zeruns/Synchronous-Rectification-Buck-Boost-Digital-Power-Supply-Based-on-STM32/MDK-ARM/build/Buck-Boost/Buck-Boost.htm

# Static Call Graph for image ./build/Buck-Boost/Buck-Boost.axf

#<CALLGRAPH># ARM Linker, 6210000: Last Updated: Tue Jun 4 23:03:58 2024

### Maximum Stack Usage = 508 bytes + Unknown(Functions without stacksize, Cycles, Untraceable Function Pointers)

### Call chain for Maximum Stack Depth:

__rt_entry_main ⇒ main ⇒ MX_HRTIM1_Init ⇒ HAL_HRTIM_WaveformTimerConfig

### Functions with no stack information

- __user_initial_stackheap

### Mutually Recursive functions

- ADC1_2_IRQHandler ⇒ ADC1_2_IRQHandler
- BusFault_Handler ⇒ BusFault_Handler
- HardFault_Handler ⇒ HardFault_Handler
- MemManage_Handler ⇒ MemManage_Handler
- UsageFault_Handler ⇒ UsageFault_Handler

### Function Pointers

- ADC1_2_IRQHandler from startup_stm32g474xx.o(.text) referenced from startup_stm32g474xx.o(RESET)
- ADC3_IRQHandler from startup_stm32g474xx.o(.text) referenced from startup_stm32g474xx.o(RESET)
- ADC4_IRQHandler from startup_stm32g474xx.o(.text) referenced from startup_stm32g474xx.o(RESET)
- ADC5_IRQHandler from startup_stm32g474xx.o(.text) referenced from startup_stm32g474xx.o(RESET)
- ADC_DMAConvCplt from stm32g4xx_hal_adc.o(.text.ADC_DMAConvCplt) referenced 2 times from stm32g4xx_hal_adc.o(.text.HAL_ADC_Start_DMA)
- ADC_DMAError from stm32g4xx_hal_adc.o(.text.ADC_DMAError) referenced 2 times from stm32g4xx_hal_adc.o(.text.HAL_ADC_Start_DMA)
- ADC_DMAHalfConvCplt from stm32g4xx_hal_adc.o(.text.ADC_DMAHalfConvCplt) referenced 2 times from stm32g4xx_hal_adc.o(.text.HAL_ADC_Start_DMA)
- BusFault_Handler from stm32g4xx_it.o(.text.BusFault_Handler) referenced from startup_stm32g474xx.o(RESET)
- COMP1_2_3_IRQHandler from startup_stm32g474xx.o(.text) referenced from startup_stm32g474xx.o(RESET)
- COMP4_5_6_IRQHandler from startup_stm32g474xx.o(.text) referenced from startup_stm32g474xx.o(RESET)
- COMP7_IRQHandler from startup_stm32g474xx.o(.text) referenced from startup_stm32g474xx.o(RESET)
- CORDIC_IRQHandler from startup_stm32g474xx.o(.text) referenced from startup_stm32g474xx.o(RESET)
- CRS_IRQHandler from startup_stm32g474xx.o(.text) referenced from startup_stm32g474xx.o(RESET)
- DMA1_Channel1_IRQHandler from stm32g4xx_it.o(.text.DMA1_Channel1_IRQHandler) referenced from startup_stm32g474xx.o(RESET)
- DMA1_Channel2_IRQHandler from stm32g4xx_it.o(.text.DMA1_Channel2_IRQHandler) referenced from startup_stm32g474xx.o(RESET)
- DMA1_Channel3_IRQHandler from stm32g4xx_it.o(.text.DMA1_Channel3_IRQHandler) referenced from startup_stm32g474xx.o(RESET)
- DMA1_Channel4_IRQHandler from startup_stm32g474xx.o(.text) referenced from startup_stm32g474xx.o(RESET)
- DMA1_Channel5_IRQHandler from startup_stm32g474xx.o(.text) referenced from startup_stm32g474xx.o(RESET)
- DMA1_Channel6_IRQHandler from startup_stm32g474xx.o(.text) referenced from startup_stm32g474xx.o(RESET)
- DMA1_Channel7_IRQHandler from startup_stm32g474xx.o(.text) referenced from startup_stm32g474xx.o(RESET)
- DMA1_Channel8_IRQHandler from startup_stm32g474xx.o(.text) referenced from startup_stm32g474xx.o(RESET)
- DMA2_Channel1_IRQHandler from startup_stm32g474xx.o(.text) referenced from startup_stm32g474xx.o(RESET)
- DMA2_Channel2_IRQHandler from startup_stm32g474xx.o(.text) referenced from startup_stm32g474xx.o(RESET)
- DMA2_Channel3_IRQHandler from startup_stm32g474xx.o(.text) referenced from startup_stm32g474xx.o(RESET)
- DMA2_Channel4_IRQHandler from startup_stm32g474xx.o(.text) referenced from startup_stm32g474xx.o(RESET)
- DMA2_Channel5_IRQHandler from startup_stm32g474xx.o(.text) referenced from startup_stm32g474xx.o(RESET)
- DMA2_Channel6_IRQHandler from startup_stm32g474xx.o(.text) referenced from startup_stm32g474xx.o(RESET)
- DMA2_Channel7_IRQHandler from startup_stm32g474xx.o(.text) referenced from startup_stm32g474xx.o(RESET)
- DMA2_Channel8_IRQHandler from startup_stm32g474xx.o(.text) referenced from startup_stm32g474xx.o(RESET)
- DMAMUX_OVR_IRQHandler from startup_stm32g474xx.o(.text) referenced from startup_stm32g474xx.o(RESET)
- DebugMon_Handler from stm32g4xx_it.o(.text.DebugMon_Handler) referenced from startup_stm32g474xx.o(RESET)
- EXTI0_IRQHandler from stm32g4xx_it.o(.text.EXTI0_IRQHandler) referenced from startup_stm32g474xx.o(RESET)
- EXTI15_10_IRQHandler from startup_stm32g474xx.o(.text) referenced from startup_stm32g474xx.o(RESET)
- EXTI1_IRQHandler from startup_stm32g474xx.o(.text) referenced from startup_stm32g474xx.o(RESET)
- EXTI2_IRQHandler from startup_stm32g474xx.o(.text) referenced from startup_stm32g474xx.o(RESET)
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
- RTC_WKUP_IRQHandler from startup_stm32g474xx.o(.text) referenced from startup_stm32g474xx.o(RESET)
- Reset_Handler from startup_stm32g474xx.o(.text) referenced from startup_stm32g474xx.o(RESET)
- SAI1_IRQHandler from startup_stm32g474xx.o(.text) referenced from startup_stm32g474xx.o(RESET)
- SPI1_IRQHandler from startup_stm32g474xx.o(.text) referenced from startup_stm32g474xx.o(RESET)
- SPI2_IRQHandler from startup_stm32g474xx.o(.text) referenced from startup_stm32g474xx.o(RESET)
- SPI3_IRQHandler from startup_stm32g474xx.o(.text) referenced from startup_stm32g474xx.o(RESET)
- SPI4_IRQHandler from startup_stm32g474xx.o(.text) referenced from startup_stm32g474xx.o(RESET)
- SVC_Handler from stm32g4xx_it.o(.text.SVC_Handler) referenced from startup_stm32g474xx.o(RESET)
- SysTick_Handler from stm32g4xx_it.o(.text.SysTick_Handler) referenced from startup_stm32g474xx.o(RESET)
- SystemInit from system_stm32g4xx.o(.text.SystemInit) referenced from startup_stm32g474xx.o(.text)
- TIM1_BRK_TIM15_IRQHandler from startup_stm32g474xx.o(.text) referenced from startup_stm32g474xx.o(RESET)
- TIM1_CC_IRQHandler from startup_stm32g474xx.o(.text) referenced from startup_stm32g474xx.o(RESET)
- TIM1_TRG_COM_TIM17_IRQHandler from startup_stm32g474xx.o(.text) referenced from startup_stm32g474xx.o(RESET)
- TIM1_UP_TIM16_IRQHandler from startup_stm32g474xx.o(.text) referenced from startup_stm32g474xx.o(RESET)
- TIM20_BRK_IRQHandler from startup_stm32g474xx.o(.text) referenced from startup_stm32g474xx.o(RESET)
- TIM20_CC_IRQHandler from startup_stm32g474xx.o(.text) referenced from startup_stm32g474xx.o(RESET)
- TIM20_TRG_COM_IRQHandler from startup_stm32g474xx.o(.text) referenced from startup_stm32g474xx.o(RESET)
- TIM20_UP_IRQHandler from startup_stm32g474xx.o(.text) referenced from startup_stm32g474xx.o(RESET)
- TIM2_IRQHandler from stm32g4xx_it.o(.text.TIM2_IRQHandler) referenced from startup_stm32g474xx.o(RESET)
- TIM3_IRQHandler from stm32g4xx_it.o(.text.TIM3_IRQHandler) referenced from startup_stm32g474xx.o(RESET)
- TIM4_IRQHandler from stm32g4xx_it.o(.text.TIM4_IRQHandler) referenced from startup_stm32g474xx.o(RESET)
- TIM5_IRQHandler from startup_stm32g474xx.o(.text) referenced from startup_stm32g474xx.o(RESET)
- TIM6_DAC_IRQHandler from startup_stm32g474xx.o(.text) referenced from startup_stm32g474xx.o(RESET)
- TIM7_DAC_IRQHandler from startup_stm32g474xx.o(.text) referenced from startup_stm32g474xx.o(RESET)
- TIM8_BRK_IRQHandler from startup_stm32g474xx.o(.text) referenced from startup_stm32g474xx.o(RESET)
- TIM8_CC_IRQHandler from startup_stm32g474xx.o(.text) referenced from startup_stm32g474xx.o(RESET)
- TIM8_TRG_COM_IRQHandler from startup_stm32g474xx.o(.text) referenced from startup_stm32g474xx.o(RESET)
- TIM8_UP_IRQHandler from startup_stm32g474xx.o(.text) referenced from startup_stm32g474xx.o(RESET)
- UART4_IRQHandler from startup_stm32g474xx.o(.text) referenced from startup_stm32g474xx.o(RESET)
- UART5_IRQHandler from startup_stm32g474xx.o(.text) referenced from startup_stm32g474xx.o(RESET)
- UART_DMAAbortOnError from stm32g4xx_hal_uart.o(.text.UART_DMAAbortOnError) referenced 2 times from stm32g4xx_hal_uart.o(.text.HAL_UART_IRQHandler)
- UART_DMAError from stm32g4xx_hal_uart.o(.text.UART_DMAError) referenced 2 times from stm32g4xx_hal_uart.o(.text.HAL_UART_Transmit_DMA)
- UART_DMATransmitCplt from stm32g4xx_hal_uart.o(.text.UART_DMATransmitCplt) referenced 2 times from stm32g4xx_hal_uart.o(.text.HAL_UART_Transmit_DMA)
- UART_DMATxHalfCplt from stm32g4xx_hal_uart.o(.text.UART_DMATxHalfCplt) referenced 2 times from stm32g4xx_hal_uart.o(.text.HAL_UART_Transmit_DMA)
- UCPD1_IRQHandler from startup_stm32g474xx.o(.text) referenced from startup_stm32g474xx.o(RESET)
- USART1_IRQHandler from stm32g4xx_it.o(.text.USART1_IRQHandler) referenced from startup_stm32g474xx.o(RESET)
- USART2_IRQHandler from startup_stm32g474xx.o(.text) referenced from startup_stm32g474xx.o(RESET)
- USART3_IRQHandler from startup_stm32g474xx.o(.text) referenced from startup_stm32g474xx.o(RESET)
- USBWakeUp_IRQHandler from startup_stm32g474xx.o(.text) referenced from startup_stm32g474xx.o(RESET)
- USB_HP_IRQHandler from startup_stm32g474xx.o(.text) referenced from startup_stm32g474xx.o(RESET)
- USB_LP_IRQHandler from startup_stm32g474xx.o(.text) referenced from startup_stm32g474xx.o(RESET)
- UsageFault_Handler from stm32g4xx_it.o(.text.UsageFault_Handler) referenced from startup_stm32g474xx.o(RESET)
- WWDG_IRQHandler from startup_stm32g474xx.o(.text) referenced from startup_stm32g474xx.o(RESET)
- __main from __main.o(!!!main) referenced from startup_stm32g474xx.o(.text)
- _get_lc_ctype from lc_ctype_c.o(locale$$code) referenced from rt_ctype_table.o(.text)
- _printf_input_char from _printf_char_common.o(.text) referenced from _printf_char_common.o(.text)
- _snputc from _snputc.o(.text) referenced from vsnprintf.o(.text)
- _sputc from _sputc.o(.text) referenced from vsprintf.o(.text)

### Global Symbols

__main (Thumb, 8 bytes, Stack size 0 bytes, __main.o(!!!main))

[Calls]

- >> __rt_entry
- >> __scatterload

[Address Reference Count : 1]

- startup_stm32g474xx.o(.text)

__scatterload (Thumb, 0 bytes, Stack size unknown bytes, __scatter.o(!!!scatter))

[Called By]

- >> __main

__scatterload_rt2 (Thumb, 84 bytes, Stack size unknown bytes, __scatter.o(!!!scatter), UNUSED)

[Calls]

- >> __rt_entry

__scatterload_rt2_thumb_only (Thumb, 0 bytes, Stack size unknown bytes, __scatter.o(!!!scatter), UNUSED)

__scatterload_loop (Thumb, 0 bytes, Stack size unknown bytes, __scatter.o(!!!scatter), UNUSED)

__scatterload_copy (Thumb, 26 bytes, Stack size unknown bytes, __scatter_copy.o(!!handler_copy), UNUSED)

[Calls]

- >> __scatterload_copy

[Called By]

- >> __scatterload_copy

__scatterload_null (Thumb, 2 bytes, Stack size unknown bytes, __scatter.o(!!handler_null), UNUSED)

__scatterload_zeroinit (Thumb, 28 bytes, Stack size unknown bytes, __scatter_zi.o(!!handler_zi), UNUSED)

_printf_n (Thumb, 0 bytes, Stack size unknown bytes, _printf_n.o(.ARM.Collect$$_printf_percent$$00000001))

[Calls]

- >> _printf_charcount

_printf_percent (Thumb, 0 bytes, Stack size unknown bytes, _printf_percent.o(.ARM.Collect$$_printf_percent$$00000000))

[Called By]

- >> __printf

_printf_p (Thumb, 0 bytes, Stack size unknown bytes, _printf_p.o(.ARM.Collect$$_printf_percent$$00000002))

[Stack]

- Max Depth = 64 + Unknown Stack Size
- Call Chain = _printf_p ⇒ _printf_hex_ptr ⇒ _printf_longlong_hex ⇒ _printf_int_common ⇒ _printf_post_padding

[Calls]

- >> _printf_hex_ptr

_printf_f (Thumb, 0 bytes, Stack size unknown bytes, _printf_f.o(.ARM.Collect$$_printf_percent$$00000003))

[Stack]

- Max Depth = 324 + Unknown Stack Size
- Call Chain = _printf_f ⇒ _printf_fp_dec ⇒ _printf_fp_dec_real ⇒ _fp_digits ⇒ _btod_etento ⇒ _btod_emul ⇒ _e2e

[Calls]

- >> _printf_fp_dec

_printf_e (Thumb, 0 bytes, Stack size unknown bytes, _printf_e.o(.ARM.Collect$$_printf_percent$$00000004))

[Stack]

- Max Depth = 324 + Unknown Stack Size
- Call Chain = _printf_e ⇒ _printf_fp_dec ⇒ _printf_fp_dec_real ⇒ _fp_digits ⇒ _btod_etento ⇒ _btod_emul ⇒ _e2e

[Calls]

- >> _printf_fp_dec

_printf_g (Thumb, 0 bytes, Stack size unknown bytes, _printf_g.o(.ARM.Collect$$_printf_percent$$00000005))

[Stack]

- Max Depth = 324 + Unknown Stack Size
- Call Chain = _printf_g ⇒ _printf_fp_dec ⇒ _printf_fp_dec_real ⇒ _fp_digits ⇒ _btod_etento ⇒ _btod_emul ⇒ _e2e

[Calls]

- >> _printf_fp_dec

_printf_a (Thumb, 0 bytes, Stack size unknown bytes, _printf_a.o(.ARM.Collect$$_printf_percent$$00000006))

[Stack]

- Max Depth = 112 + Unknown Stack Size
- Call Chain = _printf_a ⇒ _printf_fp_hex ⇒ _printf_fp_hex_real ⇒ _printf_fp_infnan ⇒ _printf_post_padding

[Calls]

- >> _printf_fp_hex

_printf_ll (Thumb, 0 bytes, Stack size unknown bytes, _printf_ll.o(.ARM.Collect$$_printf_percent$$00000007))

_printf_i (Thumb, 0 bytes, Stack size unknown bytes, _printf_i.o(.ARM.Collect$$_printf_percent$$00000008))

[Stack]

- Max Depth = 72 + Unknown Stack Size
- Call Chain = _printf_i ⇒ _printf_int_dec ⇒ _printf_int_common ⇒ _printf_post_padding

[Calls]

- >> _printf_int_dec

_printf_d (Thumb, 0 bytes, Stack size unknown bytes, _printf_d.o(.ARM.Collect$$_printf_percent$$00000009))

[Stack]

- Max Depth = 72 + Unknown Stack Size
- Call Chain = _printf_d ⇒ _printf_int_dec ⇒ _printf_int_common ⇒ _printf_post_padding

[Calls]

- >> _printf_int_dec

_printf_u (Thumb, 0 bytes, Stack size unknown bytes, _printf_u.o(.ARM.Collect$$_printf_percent$$0000000A))

[Stack]

- Max Depth = 72 + Unknown Stack Size
- Call Chain = _printf_u ⇒ _printf_int_dec ⇒ _printf_int_common ⇒ _printf_post_padding

[Calls]

- >> _printf_int_dec

_printf_o (Thumb, 0 bytes, Stack size unknown bytes, _printf_o.o(.ARM.Collect$$_printf_percent$$0000000B))

[Stack]

- Max Depth = 64 + Unknown Stack Size
- Call Chain = _printf_o ⇒ _printf_int_oct ⇒ _printf_longlong_oct ⇒ _printf_int_common ⇒ _printf_post_padding

[Calls]

- >> _printf_int_oct

_printf_x (Thumb, 0 bytes, Stack size unknown bytes, _printf_x.o(.ARM.Collect$$_printf_percent$$0000000C))

[Stack]

- Max Depth = 80 + Unknown Stack Size
- Call Chain = _printf_x ⇒ _printf_int_hex ⇒ _printf_longlong_hex ⇒ _printf_int_common ⇒ _printf_post_padding

[Calls]

- >> _printf_int_hex

_printf_lli (Thumb, 0 bytes, Stack size unknown bytes, _printf_lli.o(.ARM.Collect$$_printf_percent$$0000000D))

[Stack]

- Max Depth = 72 + Unknown Stack Size
- Call Chain = _printf_lli ⇒ _printf_longlong_dec ⇒ _printf_int_common ⇒ _printf_post_padding

[Calls]

- >> _printf_longlong_dec

_printf_lld (Thumb, 0 bytes, Stack size unknown bytes, _printf_lld.o(.ARM.Collect$$_printf_percent$$0000000E))

[Stack]

- Max Depth = 72 + Unknown Stack Size
- Call Chain = _printf_lld ⇒ _printf_longlong_dec ⇒ _printf_int_common ⇒ _printf_post_padding

[Calls]

- >> _printf_longlong_dec

_printf_llu (Thumb, 0 bytes, Stack size unknown bytes, _printf_llu.o(.ARM.Collect$$_printf_percent$$0000000F))

[Stack]

- Max Depth = 72 + Unknown Stack Size
- Call Chain = _printf_llu ⇒ _printf_longlong_dec ⇒ _printf_int_common ⇒ _printf_post_padding

[Calls]

- >> _printf_longlong_dec

_printf_llo (Thumb, 0 bytes, Stack size unknown bytes, _printf_llo.o(.ARM.Collect$$_printf_percent$$00000010))

[Stack]

- Max Depth = 56 + Unknown Stack Size
- Call Chain = _printf_llo ⇒ _printf_ll_oct ⇒ _printf_longlong_oct ⇒ _printf_int_common ⇒ _printf_post_padding

[Calls]

- >> _printf_ll_oct

_printf_llx (Thumb, 0 bytes, Stack size unknown bytes, _printf_llx.o(.ARM.Collect$$_printf_percent$$00000011))

[Stack]

- Max Depth = 64 + Unknown Stack Size
- Call Chain = _printf_llx ⇒ _printf_ll_hex ⇒ _printf_longlong_hex ⇒ _printf_int_common ⇒ _printf_post_padding

[Calls]

- >> _printf_ll_hex

_printf_l (Thumb, 0 bytes, Stack size unknown bytes, _printf_l.o(.ARM.Collect$$_printf_percent$$00000012))

_printf_c (Thumb, 0 bytes, Stack size unknown bytes, _printf_c.o(.ARM.Collect$$_printf_percent$$00000013))

[Stack]

- Max Depth = 40 + Unknown Stack Size
- Call Chain = _printf_c ⇒ _printf_char ⇒ _printf_cs_common ⇒ _printf_str ⇒ _printf_post_padding

[Calls]

- >> _printf_char

_printf_s (Thumb, 0 bytes, Stack size unknown bytes, _printf_s.o(.ARM.Collect$$_printf_percent$$00000014))

[Stack]

- Max Depth = 40 + Unknown Stack Size
- Call Chain = _printf_s ⇒ _printf_string ⇒ _printf_cs_common ⇒ _printf_str ⇒ _printf_post_padding

[Calls]

- >> _printf_string

_printf_lc (Thumb, 0 bytes, Stack size unknown bytes, _printf_lc.o(.ARM.Collect$$_printf_percent$$00000015))

[Stack]

- Max Depth = 88 + Unknown Stack Size
- Call Chain = _printf_lc ⇒ _printf_wchar ⇒ _printf_lcs_common ⇒ _printf_wctomb ⇒ _wcrtomb

[Calls]

- >> _printf_wchar

_printf_ls (Thumb, 0 bytes, Stack size unknown bytes, _printf_ls.o(.ARM.Collect$$_printf_percent$$00000016))

[Stack]

- Max Depth = 88 + Unknown Stack Size
- Call Chain = _printf_ls ⇒ _printf_wstring ⇒ _printf_lcs_common ⇒ _printf_wctomb ⇒ _wcrtomb

[Calls]

- >> _printf_wstring

_printf_percent_end (Thumb, 0 bytes, Stack size unknown bytes, _printf_percent_end.o(.ARM.Collect$$_printf_percent$$00000017))

__rt_lib_init (Thumb, 0 bytes, Stack size unknown bytes, libinit.o(.ARM.Collect$$libinit$$00000000))

[Called By]

- >> __rt_entry_li

__rt_lib_init_fp_1 (Thumb, 0 bytes, Stack size unknown bytes, libinit2.o(.ARM.Collect$$libinit$$00000001))

[Calls]

- >> _fp_init

__rt_lib_init_heap_1 (Thumb, 0 bytes, Stack size unknown bytes, libinit2.o(.ARM.Collect$$libinit$$0000000C))

__rt_lib_init_lc_common (Thumb, 0 bytes, Stack size unknown bytes, libinit2.o(.ARM.Collect$$libinit$$00000011))

[Calls]

- >> __rt_locale

__rt_lib_init_preinit_1 (Thumb, 0 bytes, Stack size unknown bytes, libinit2.o(.ARM.Collect$$libinit$$00000006))

__rt_lib_init_rand_1 (Thumb, 0 bytes, Stack size unknown bytes, libinit2.o(.ARM.Collect$$libinit$$00000010))

__rt_lib_init_relocate_pie_1 (Thumb, 0 bytes, Stack size unknown bytes, libinit2.o(.ARM.Collect$$libinit$$00000004))

__rt_lib_init_user_alloc_1 (Thumb, 0 bytes, Stack size unknown bytes, libinit2.o(.ARM.Collect$$libinit$$0000000E))

__rt_lib_init_lc_collate_1 (Thumb, 0 bytes, Stack size unknown bytes, libinit2.o(.ARM.Collect$$libinit$$00000013))

__rt_lib_init_lc_ctype_2 (Thumb, 0 bytes, Stack size unknown bytes, libinit2.o(.ARM.Collect$$libinit$$00000014))

[Stack]

- Max Depth = 16 + Unknown Stack Size
- Call Chain = __rt_lib_init_lc_ctype_2 ⇒ _get_lc_ctype ⇒ strcmp

[Calls]

- >> _get_lc_ctype

__rt_lib_init_lc_ctype_1 (Thumb, 0 bytes, Stack size unknown bytes, libinit2.o(.ARM.Collect$$libinit$$00000015))

__rt_lib_init_lc_monetary_1 (Thumb, 0 bytes, Stack size unknown bytes, libinit2.o(.ARM.Collect$$libinit$$00000017))

__rt_lib_init_lc_numeric_2 (Thumb, 0 bytes, Stack size unknown bytes, libinit2.o(.ARM.Collect$$libinit$$00000018))

[Stack]

- Max Depth = 16 + Unknown Stack Size
- Call Chain = __rt_lib_init_lc_numeric_2 ⇒ _get_lc_numeric ⇒ strcmp

[Calls]

- >> _get_lc_numeric

__rt_lib_init_alloca_1 (Thumb, 0 bytes, Stack size unknown bytes, libinit2.o(.ARM.Collect$$libinit$$00000030))

__rt_lib_init_argv_1 (Thumb, 0 bytes, Stack size unknown bytes, libinit2.o(.ARM.Collect$$libinit$$0000002E))

__rt_lib_init_atexit_1 (Thumb, 0 bytes, Stack size unknown bytes, libinit2.o(.ARM.Collect$$libinit$$0000001D))

__rt_lib_init_clock_1 (Thumb, 0 bytes, Stack size unknown bytes, libinit2.o(.ARM.Collect$$libinit$$00000023))

__rt_lib_init_cpp_1 (Thumb, 0 bytes, Stack size unknown bytes, libinit2.o(.ARM.Collect$$libinit$$00000034))

__rt_lib_init_exceptions_1 (Thumb, 0 bytes, Stack size unknown bytes, libinit2.o(.ARM.Collect$$libinit$$00000032))

__rt_lib_init_fp_trap_1 (Thumb, 0 bytes, Stack size unknown bytes, libinit2.o(.ARM.Collect$$libinit$$00000021))

__rt_lib_init_getenv_1 (Thumb, 0 bytes, Stack size unknown bytes, libinit2.o(.ARM.Collect$$libinit$$00000025))

__rt_lib_init_lc_numeric_1 (Thumb, 0 bytes, Stack size unknown bytes, libinit2.o(.ARM.Collect$$libinit$$00000019))

__rt_lib_init_lc_time_1 (Thumb, 0 bytes, Stack size unknown bytes, libinit2.o(.ARM.Collect$$libinit$$0000001B))

__rt_lib_init_return (Thumb, 0 bytes, Stack size unknown bytes, libinit2.o(.ARM.Collect$$libinit$$00000035))

__rt_lib_init_signal_1 (Thumb, 0 bytes, Stack size unknown bytes, libinit2.o(.ARM.Collect$$libinit$$0000001F))

__rt_lib_init_stdio_1 (Thumb, 0 bytes, Stack size unknown bytes, libinit2.o(.ARM.Collect$$libinit$$00000027))

__rt_lib_shutdown (Thumb, 0 bytes, Stack size unknown bytes, libshutdown.o(.ARM.Collect$$libshutdown$$00000000))

[Called By]

- >> __rt_exit_ls

__rt_lib_shutdown_cpp_1 (Thumb, 0 bytes, Stack size unknown bytes, libshutdown2.o(.ARM.Collect$$libshutdown$$00000002))

__rt_lib_shutdown_fp_trap_1 (Thumb, 0 bytes, Stack size unknown bytes, libshutdown2.o(.ARM.Collect$$libshutdown$$00000007))

__rt_lib_shutdown_heap_1 (Thumb, 0 bytes, Stack size unknown bytes, libshutdown2.o(.ARM.Collect$$libshutdown$$0000000F))

__rt_lib_shutdown_return (Thumb, 0 bytes, Stack size unknown bytes, libshutdown2.o(.ARM.Collect$$libshutdown$$00000010))

__rt_lib_shutdown_signal_1 (Thumb, 0 bytes, Stack size unknown bytes, libshutdown2.o(.ARM.Collect$$libshutdown$$0000000A))

__rt_lib_shutdown_stdio_1 (Thumb, 0 bytes, Stack size unknown bytes, libshutdown2.o(.ARM.Collect$$libshutdown$$00000004))

__rt_lib_shutdown_user_alloc_1 (Thumb, 0 bytes, Stack size unknown bytes, libshutdown2.o(.ARM.Collect$$libshutdown$$0000000C))

__rt_entry (Thumb, 0 bytes, Stack size unknown bytes, __rtentry.o(.ARM.Collect$$rtentry$$00000000))

[Called By]

- >> __main
- >> __scatterload_rt2

__rt_entry_presh_1 (Thumb, 0 bytes, Stack size unknown bytes, __rtentry2.o(.ARM.Collect$$rtentry$$00000002))

__rt_entry_sh (Thumb, 0 bytes, Stack size unknown bytes, __rtentry4.o(.ARM.Collect$$rtentry$$00000004))

[Stack]

- Max Depth = 8 + Unknown Stack Size
- Call Chain = __rt_entry_sh ⇒ __user_setup_stackheap

[Calls]

- >> __user_setup_stackheap

__rt_entry_li (Thumb, 0 bytes, Stack size unknown bytes, __rtentry2.o(.ARM.Collect$$rtentry$$0000000A))

[Calls]

- >> __rt_lib_init

__rt_entry_postsh_1 (Thumb, 0 bytes, Stack size unknown bytes, __rtentry2.o(.ARM.Collect$$rtentry$$00000009))

__rt_entry_main (Thumb, 0 bytes, Stack size unknown bytes, __rtentry2.o(.ARM.Collect$$rtentry$$0000000D))

[Stack]

- Max Depth = 508 + Unknown Stack Size
- Call Chain = __rt_entry_main ⇒ main ⇒ MX_HRTIM1_Init ⇒ HAL_HRTIM_WaveformTimerConfig

[Calls]

- >> main
- >> exit

__rt_entry_postli_1 (Thumb, 0 bytes, Stack size unknown bytes, __rtentry2.o(.ARM.Collect$$rtentry$$0000000C))

__rt_exit (Thumb, 0 bytes, Stack size unknown bytes, rtexit.o(.ARM.Collect$$rtexit$$00000000))

[Called By]

- >> exit

__rt_exit_ls (Thumb, 0 bytes, Stack size unknown bytes, rtexit2.o(.ARM.Collect$$rtexit$$00000003))

[Calls]

- >> __rt_lib_shutdown

__rt_exit_prels_1 (Thumb, 0 bytes, Stack size unknown bytes, rtexit2.o(.ARM.Collect$$rtexit$$00000002))

__rt_exit_exit (Thumb, 0 bytes, Stack size unknown bytes, rtexit2.o(.ARM.Collect$$rtexit$$00000004))

[Calls]

- >> _sys_exit

Reset_Handler (Thumb, 8 bytes, Stack size 0 bytes, startup_stm32g474xx.o(.text))
[Address Reference Count : 1]

- startup_stm32g474xx.o(RESET)

ADC1_2_IRQHandler (Thumb, 0 bytes, Stack size 0 bytes, startup_stm32g474xx.o(.text))

[Calls]

- >> ADC1_2_IRQHandler

[Called By]

- >> ADC1_2_IRQHandler

[Address Reference Count : 1]

- startup_stm32g474xx.o(RESET)

ADC3_IRQHandler (Thumb, 0 bytes, Stack size 0 bytes, startup_stm32g474xx.o(.text))
[Address Reference Count : 1]

- startup_stm32g474xx.o(RESET)

ADC4_IRQHandler (Thumb, 0 bytes, Stack size 0 bytes, startup_stm32g474xx.o(.text))
[Address Reference Count : 1]

- startup_stm32g474xx.o(RESET)

ADC5_IRQHandler (Thumb, 0 bytes, Stack size 0 bytes, startup_stm32g474xx.o(.text))
[Address Reference Count : 1]

- startup_stm32g474xx.o(RESET)

COMP1_2_3_IRQHandler (Thumb, 0 bytes, Stack size 0 bytes, startup_stm32g474xx.o(.text))
[Address Reference Count : 1]

- startup_stm32g474xx.o(RESET)

COMP4_5_6_IRQHandler (Thumb, 0 bytes, Stack size 0 bytes, startup_stm32g474xx.o(.text))
[Address Reference Count : 1]

- startup_stm32g474xx.o(RESET)

COMP7_IRQHandler (Thumb, 0 bytes, Stack size 0 bytes, startup_stm32g474xx.o(.text))
[Address Reference Count : 1]

- startup_stm32g474xx.o(RESET)

CORDIC_IRQHandler (Thumb, 0 bytes, Stack size 0 bytes, startup_stm32g474xx.o(.text))
[Address Reference Count : 1]

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

- startup_stm32g474xx.o(RESET)

TIM20_UP_IRQHandler (Thumb, 0 bytes, Stack size 0 bytes, startup_stm32g474xx.o(.text))
[Address Reference Count : 1]

- startup_stm32g474xx.o(RESET)

TIM5_IRQHandler (Thumb, 0 bytes, Stack size 0 bytes, startup_stm32g474xx.o(.text))
[Address Reference Count : 1]

- startup_stm32g474xx.o(RESET)

TIM6_DAC_IRQHandler (Thumb, 0 bytes, Stack size 0 bytes, startup_stm32g474xx.o(.text))
[Address Reference Count : 1]

- startup_stm32g474xx.o(RESET)

TIM7_DAC_IRQHandler (Thumb, 0 bytes, Stack size 0 bytes, startup_stm32g474xx.o(.text))
[Address Reference Count : 1]

- startup_stm32g474xx.o(RESET)

TIM8_BRK_IRQHandler (Thumb, 0 bytes, Stack size 0 bytes, startup_stm32g474xx.o(.text))
[Address Reference Count : 1]

- startup_stm32g474xx.o(RESET)

TIM8_CC_IRQHandler (Thumb, 0 bytes, Stack size 0 bytes, startup_stm32g474xx.o(.text))
[Address Reference Count : 1]

- startup_stm32g474xx.o(RESET)

TIM8_TRG_COM_IRQHandler (Thumb, 0 bytes, Stack size 0 bytes, startup_stm32g474xx.o(.text))
[Address Reference Count : 1]

- startup_stm32g474xx.o(RESET)

TIM8_UP_IRQHandler (Thumb, 0 bytes, Stack size 0 bytes, startup_stm32g474xx.o(.text))
[Address Reference Count : 1]

- startup_stm32g474xx.o(RESET)

UART4_IRQHandler (Thumb, 0 bytes, Stack size 0 bytes, startup_stm32g474xx.o(.text))
[Address Reference Count : 1]

- startup_stm32g474xx.o(RESET)

UART5_IRQHandler (Thumb, 0 bytes, Stack size 0 bytes, startup_stm32g474xx.o(.text))
[Address Reference Count : 1]

- startup_stm32g474xx.o(RESET)

UCPD1_IRQHandler (Thumb, 0 bytes, Stack size 0 bytes, startup_stm32g474xx.o(.text))
[Address Reference Count : 1]

- startup_stm32g474xx.o(RESET)

USART2_IRQHandler (Thumb, 0 bytes, Stack size 0 bytes, startup_stm32g474xx.o(.text))
[Address Reference Count : 1]

- startup_stm32g474xx.o(RESET)

USART3_IRQHandler (Thumb, 0 bytes, Stack size 0 bytes, startup_stm32g474xx.o(.text))
[Address Reference Count : 1]

- startup_stm32g474xx.o(RESET)

USBWakeUp_IRQHandler (Thumb, 0 bytes, Stack size 0 bytes, startup_stm32g474xx.o(.text))
[Address Reference Count : 1]

- startup_stm32g474xx.o(RESET)

USB_HP_IRQHandler (Thumb, 0 bytes, Stack size 0 bytes, startup_stm32g474xx.o(.text))
[Address Reference Count : 1]

- startup_stm32g474xx.o(RESET)

USB_LP_IRQHandler (Thumb, 0 bytes, Stack size 0 bytes, startup_stm32g474xx.o(.text))
[Address Reference Count : 1]

- startup_stm32g474xx.o(RESET)

WWDG_IRQHandler (Thumb, 0 bytes, Stack size 0 bytes, startup_stm32g474xx.o(.text))
[Address Reference Count : 1]

- startup_stm32g474xx.o(RESET)

__user_initial_stackheap (Thumb, 0 bytes, Stack size unknown bytes, startup_stm32g474xx.o(.text))

[Called By]

- >> __user_setup_stackheap

__aeabi_uldivmod (Thumb, 0 bytes, Stack size 48 bytes, lludivv7m.o(.text))

[Stack]

- Max Depth = 48
- Call Chain = __aeabi_uldivmod

[Called By]

- >> UART_SetConfig

_ll_udiv (Thumb, 240 bytes, Stack size 48 bytes, lludivv7m.o(.text), UNUSED)

vsprintf (Thumb, 32 bytes, Stack size 16 bytes, vsprintf.o(.text))

[Stack]

- Max Depth = 120 + Unknown Stack Size
- Call Chain = vsprintf ⇒ _printf_char_common ⇒ __printf

[Calls]

- >> _sputc
- >> _printf_char_common

[Called By]

- >> OLED_Printf

vsnprintf (Thumb, 56 bytes, Stack size 24 bytes, vsnprintf.o(.text))

[Stack]

- Max Depth = 128 + Unknown Stack Size
- Call Chain = vsnprintf ⇒ _printf_char_common ⇒ __printf

[Calls]

- >> _printf_char_common

[Called By]

- >> USART1_Printf

__aeabi_memcpy (Thumb, 0 bytes, Stack size 0 bytes, rt_memcpy_v6.o(.text))

[Called By]

- >> OLED_Update

__rt_memcpy (Thumb, 138 bytes, Stack size 0 bytes, rt_memcpy_v6.o(.text), UNUSED)

[Calls]

- >> __aeabi_memcpy4

_memcpy_lastbytes (Thumb, 0 bytes, Stack size unknown bytes, rt_memcpy_v6.o(.text), UNUSED)

__aeabi_memclr4 (Thumb, 0 bytes, Stack size unknown bytes, rt_memclr_w.o(.text))

[Called By]

- >> HAL_UART_MspInit
- >> MX_TIM8_Init
- >> HAL_I2C_MspInit
- >> MX_HRTIM1_Init
- >> HAL_ADC_MspInit

__aeabi_memclr8 (Thumb, 0 bytes, Stack size unknown bytes, rt_memclr_w.o(.text), UNUSED)

__rt_memclr_w (Thumb, 0 bytes, Stack size unknown bytes, rt_memclr_w.o(.text), UNUSED)

_memset_w (Thumb, 74 bytes, Stack size 4 bytes, rt_memclr_w.o(.text), UNUSED)

strcmp (Thumb, 124 bytes, Stack size 8 bytes, strcmpv7em.o(.text))

[Stack]

- Max Depth = 8
- Call Chain = strcmp

[Called By]

- >> OLED_ShowChinese
- >> _get_lc_ctype
- >> _get_lc_numeric

__use_two_region_memory (Thumb, 2 bytes, Stack size 0 bytes, heapauxi.o(.text), UNUSED)

__rt_heap_escrow$2region (Thumb, 2 bytes, Stack size 0 bytes, heapauxi.o(.text), UNUSED)

__rt_heap_expand$2region (Thumb, 2 bytes, Stack size 0 bytes, heapauxi.o(.text), UNUSED)

__read_errno (Thumb, 10 bytes, Stack size 8 bytes, _rserrno.o(.text), UNUSED)

[Calls]

- >> __aeabi_errno_addr

__set_errno (Thumb, 12 bytes, Stack size 8 bytes, _rserrno.o(.text))

[Stack]

- Max Depth = 8
- Call Chain = __set_errno

[Calls]

- >> __aeabi_errno_addr

[Called By]

- >> __hardfp_log

_printf_pre_padding (Thumb, 44 bytes, Stack size 16 bytes, _printf_pad.o(.text))

[Stack]

- Max Depth = 16
- Call Chain = _printf_pre_padding

[Called By]

- >> _printf_wctomb
- >> _printf_str
- >> _printf_fp_infnan
- >> _printf_fp_hex_real
- >> _printf_fp_dec_real
- >> _printf_int_common

_printf_post_padding (Thumb, 34 bytes, Stack size 16 bytes, _printf_pad.o(.text))

[Stack]

- Max Depth = 16
- Call Chain = _printf_post_padding

[Called By]

- >> _printf_wctomb
- >> _printf_str
- >> _printf_fp_infnan
- >> _printf_fp_hex_real
- >> _printf_fp_dec_real
- >> _printf_int_common

_printf_truncate_signed (Thumb, 18 bytes, Stack size 0 bytes, _printf_truncate.o(.text))

[Called By]

- >> _printf_int_dec

_printf_truncate_unsigned (Thumb, 18 bytes, Stack size 0 bytes, _printf_truncate.o(.text))

[Called By]

- >> _printf_int_hex
- >> _printf_int_oct
- >> _printf_int_dec

_printf_str (Thumb, 82 bytes, Stack size 16 bytes, _printf_str.o(.text))

[Stack]

- Max Depth = 32
- Call Chain = _printf_str ⇒ _printf_post_padding

[Calls]

- >> _printf_post_padding
- >> _printf_pre_padding

[Called By]

- >> _printf_cs_common

_printf_int_dec (Thumb, 104 bytes, Stack size 24 bytes, _printf_dec.o(.text))

[Stack]

- Max Depth = 72
- Call Chain = _printf_int_dec ⇒ _printf_int_common ⇒ _printf_post_padding

[Calls]

- >> _printf_truncate_unsigned
- >> _printf_truncate_signed
- >> _printf_int_common

[Called By]

- >> _printf_u
- >> _printf_d
- >> _printf_i

_printf_charcount (Thumb, 40 bytes, Stack size 0 bytes, _printf_charcount.o(.text))

[Called By]

- >> _printf_n

_printf_char_common (Thumb, 32 bytes, Stack size 64 bytes, _printf_char_common.o(.text))

[Stack]

- Max Depth = 104 + Unknown Stack Size
- Call Chain = _printf_char_common ⇒ __printf

[Calls]

- >> __printf

[Called By]

- >> vsnprintf
- >> vsprintf

_sputc (Thumb, 10 bytes, Stack size 0 bytes, _sputc.o(.text))

[Called By]

- >> vsprintf

[Address Reference Count : 1]

- vsprintf.o(.text)

_snputc (Thumb, 16 bytes, Stack size 0 bytes, _snputc.o(.text))
[Address Reference Count : 1]

- vsnprintf.o(.text)

_printf_wctomb (Thumb, 182 bytes, Stack size 56 bytes, _printf_wctomb.o(.text))

[Stack]

- Max Depth = 80
- Call Chain = _printf_wctomb ⇒ _wcrtomb

[Calls]

- >> _printf_post_padding
- >> _printf_pre_padding
- >> _wcrtomb

[Called By]

- >> _printf_lcs_common

_printf_longlong_dec (Thumb, 108 bytes, Stack size 24 bytes, _printf_longlong_dec.o(.text))

[Stack]

- Max Depth = 72
- Call Chain = _printf_longlong_dec ⇒ _printf_int_common ⇒ _printf_post_padding

[Calls]

- >> _printf_int_common
- >> _ll_udiv10

[Called By]

- >> _printf_llu
- >> _printf_lld
- >> _printf_lli

_printf_longlong_oct (Thumb, 68 bytes, Stack size 8 bytes, _printf_oct_int_ll.o(.text))

[Stack]

- Max Depth = 56
- Call Chain = _printf_longlong_oct ⇒ _printf_int_common ⇒ _printf_post_padding

[Calls]

- >> _printf_int_common

[Called By]

- >> _printf_ll_oct
- >> _printf_int_oct

_printf_int_oct (Thumb, 24 bytes, Stack size 8 bytes, _printf_oct_int_ll.o(.text))

[Stack]

- Max Depth = 64
- Call Chain = _printf_int_oct ⇒ _printf_longlong_oct ⇒ _printf_int_common ⇒ _printf_post_padding

[Calls]

- >> _printf_longlong_oct
- >> _printf_truncate_unsigned

[Called By]

- >> _printf_o

_printf_ll_oct (Thumb, 12 bytes, Stack size 0 bytes, _printf_oct_int_ll.o(.text))

[Stack]

- Max Depth = 56
- Call Chain = _printf_ll_oct ⇒ _printf_longlong_oct ⇒ _printf_int_common ⇒ _printf_post_padding

[Calls]

- >> _printf_longlong_oct

[Called By]

- >> _printf_llo

_printf_longlong_hex (Thumb, 86 bytes, Stack size 16 bytes, _printf_hex_int_ll_ptr.o(.text))

[Stack]

- Max Depth = 64
- Call Chain = _printf_longlong_hex ⇒ _printf_int_common ⇒ _printf_post_padding

[Calls]

- >> _printf_int_common

[Called By]

- >> _printf_hex_ptr
- >> _printf_ll_hex
- >> _printf_int_hex

_printf_int_hex (Thumb, 28 bytes, Stack size 16 bytes, _printf_hex_int_ll_ptr.o(.text))

[Stack]

- Max Depth = 80
- Call Chain = _printf_int_hex ⇒ _printf_longlong_hex ⇒ _printf_int_common ⇒ _printf_post_padding

[Calls]

- >> _printf_longlong_hex
- >> _printf_truncate_unsigned

[Called By]

- >> _printf_x

_printf_ll_hex (Thumb, 12 bytes, Stack size 0 bytes, _printf_hex_int_ll_ptr.o(.text))

[Stack]

- Max Depth = 64
- Call Chain = _printf_ll_hex ⇒ _printf_longlong_hex ⇒ _printf_int_common ⇒ _printf_post_padding

[Calls]

- >> _printf_longlong_hex

[Called By]

- >> _printf_llx

_printf_hex_ptr (Thumb, 18 bytes, Stack size 0 bytes, _printf_hex_int_ll_ptr.o(.text))

[Stack]

- Max Depth = 64
- Call Chain = _printf_hex_ptr ⇒ _printf_longlong_hex ⇒ _printf_int_common ⇒ _printf_post_padding

[Calls]

- >> _printf_longlong_hex

[Called By]

- >> _printf_p

__printf (Thumb, 388 bytes, Stack size 40 bytes, __printf_flags_ss_wp.o(.text))

[Stack]

- Max Depth = 40 + Unknown Stack Size
- Call Chain = __printf

[Calls]

- >> _printf_percent
- >> _is_digit

[Called By]

- >> _printf_char_common

__aeabi_memcpy4 (Thumb, 0 bytes, Stack size 8 bytes, rt_memcpy_w.o(.text), UNUSED)

[Called By]

- >> __rt_memcpy

__aeabi_memcpy8 (Thumb, 0 bytes, Stack size 8 bytes, rt_memcpy_w.o(.text), UNUSED)

__rt_memcpy_w (Thumb, 100 bytes, Stack size 8 bytes, rt_memcpy_w.o(.text), UNUSED)

_memcpy_lastbytes_aligned (Thumb, 0 bytes, Stack size unknown bytes, rt_memcpy_w.o(.text), UNUSED)

__aeabi_errno_addr (Thumb, 8 bytes, Stack size 0 bytes, rt_errno_addr_intlibspace.o(.text))

[Called By]

- >> __set_errno
- >> __read_errno

__errno$intlibspace (Thumb, 0 bytes, Stack size 0 bytes, rt_errno_addr_intlibspace.o(.text), UNUSED)

__rt_errno_addr$intlibspace (Thumb, 0 bytes, Stack size 0 bytes, rt_errno_addr_intlibspace.o(.text), UNUSED)

_ll_udiv10 (Thumb, 138 bytes, Stack size 12 bytes, lludiv10.o(.text))

[Stack]

- Max Depth = 12
- Call Chain = _ll_udiv10

[Called By]

- >> _printf_longlong_dec
- >> _fp_digits

_printf_int_common (Thumb, 178 bytes, Stack size 32 bytes, _printf_intcommon.o(.text))

[Stack]

- Max Depth = 48
- Call Chain = _printf_int_common ⇒ _printf_post_padding

[Calls]

- >> _printf_post_padding
- >> _printf_pre_padding

[Called By]

- >> _printf_longlong_hex
- >> _printf_longlong_oct
- >> _printf_longlong_dec
- >> _printf_int_dec

_printf_fp_dec_real (Thumb, 620 bytes, Stack size 104 bytes, _printf_fp_dec.o(.text))

[Stack]

- Max Depth = 324
- Call Chain = _printf_fp_dec_real ⇒ _fp_digits ⇒ _btod_etento ⇒ _btod_emul ⇒ _e2e

[Calls]

- >> _printf_post_padding
- >> _printf_pre_padding
- >> _printf_fp_infnan
- >> __rt_locale
- >> __ARM_fpclassify
- >> _fp_digits

[Called By]

- >> _printf_fp_dec

_printf_fp_hex_real (Thumb, 756 bytes, Stack size 72 bytes, _printf_fp_hex.o(.text))

[Stack]

- Max Depth = 112
- Call Chain = _printf_fp_hex_real ⇒ _printf_fp_infnan ⇒ _printf_post_padding

[Calls]

- >> _printf_post_padding
- >> _printf_pre_padding
- >> _printf_fp_infnan
- >> __ARM_fpclassify

[Called By]

- >> _printf_fp_hex

_printf_cs_common (Thumb, 20 bytes, Stack size 8 bytes, _printf_char.o(.text))

[Stack]

- Max Depth = 40
- Call Chain = _printf_cs_common ⇒ _printf_str ⇒ _printf_post_padding

[Calls]

- >> _printf_str

[Called By]

- >> _printf_string
- >> _printf_char

_printf_char (Thumb, 16 bytes, Stack size 0 bytes, _printf_char.o(.text))

[Stack]

- Max Depth = 40
- Call Chain = _printf_char ⇒ _printf_cs_common ⇒ _printf_str ⇒ _printf_post_padding

[Calls]

- >> _printf_cs_common

[Called By]

- >> _printf_c

_printf_string (Thumb, 8 bytes, Stack size 0 bytes, _printf_char.o(.text))

[Stack]

- Max Depth = 40
- Call Chain = _printf_string ⇒ _printf_cs_common ⇒ _printf_str ⇒ _printf_post_padding

[Calls]

- >> _printf_cs_common

[Called By]

- >> _printf_s

_printf_lcs_common (Thumb, 20 bytes, Stack size 8 bytes, _printf_wchar.o(.text))

[Stack]

- Max Depth = 88
- Call Chain = _printf_lcs_common ⇒ _printf_wctomb ⇒ _wcrtomb

[Calls]

- >> _printf_wctomb

[Called By]

- >> _printf_wstring
- >> _printf_wchar

_printf_wchar (Thumb, 16 bytes, Stack size 0 bytes, _printf_wchar.o(.text))

[Stack]

- Max Depth = 88
- Call Chain = _printf_wchar ⇒ _printf_lcs_common ⇒ _printf_wctomb ⇒ _wcrtomb

[Calls]

- >> _printf_lcs_common

[Called By]

- >> _printf_lc

_printf_wstring (Thumb, 8 bytes, Stack size 0 bytes, _printf_wchar.o(.text))

[Stack]

- Max Depth = 88
- Call Chain = _printf_wstring ⇒ _printf_lcs_common ⇒ _printf_wctomb ⇒ _wcrtomb

[Calls]

- >> _printf_lcs_common

[Called By]

- >> _printf_ls

_c16rtomb (Thumb, 72 bytes, Stack size 24 bytes, _c16rtomb.o(.text), UNUSED)

[Calls]

- >> __rt_ctype_table

_wcrtomb (Thumb, 0 bytes, Stack size 24 bytes, _c16rtomb.o(.text))

[Stack]

- Max Depth = 24
- Call Chain = _wcrtomb

[Called By]

- >> _printf_wctomb

__user_libspace (Thumb, 8 bytes, Stack size 0 bytes, libspace.o(.text), UNUSED)

__user_perproc_libspace (Thumb, 0 bytes, Stack size 0 bytes, libspace.o(.text))

[Called By]

- >> __user_setup_stackheap

__user_perthread_libspace (Thumb, 0 bytes, Stack size 0 bytes, libspace.o(.text), UNUSED)

__user_setup_stackheap (Thumb, 74 bytes, Stack size 8 bytes, sys_stackheap_outer.o(.text))

[Stack]

- Max Depth = 8 + Unknown Stack Size
- Call Chain = __user_setup_stackheap

[Calls]

- >> __user_initial_stackheap
- >> __user_perproc_libspace

[Called By]

- >> __rt_entry_sh

__rt_ctype_table (Thumb, 16 bytes, Stack size 8 bytes, rt_ctype_table.o(.text), UNUSED)

[Calls]

- >> __rt_locale

[Called By]

- >> _c16rtomb

__rt_locale (Thumb, 8 bytes, Stack size 0 bytes, rt_locale_intlibspace.o(.text))

[Called By]

- >> __rt_lib_init_lc_common
- >> __rt_ctype_table
- >> _printf_fp_dec_real

_printf_fp_infnan (Thumb, 112 bytes, Stack size 24 bytes, _printf_fp_infnan.o(.text))

[Stack]

- Max Depth = 40
- Call Chain = _printf_fp_infnan ⇒ _printf_post_padding

[Calls]

- >> _printf_post_padding
- >> _printf_pre_padding

[Called By]

- >> _printf_fp_hex_real
- >> _printf_fp_dec_real

_btod_etento (Thumb, 224 bytes, Stack size 72 bytes, bigflt0.o(.text))

[Stack]

- Max Depth = 124
- Call Chain = _btod_etento ⇒ _btod_emul ⇒ _e2e

[Calls]

- >> _btod_emul
- >> _btod_ediv

[Called By]

- >> _fp_digits

exit (Thumb, 18 bytes, Stack size 8 bytes, exit.o(.text))

[Stack]

- Max Depth = 8 + Unknown Stack Size
- Call Chain = exit

[Calls]

- >> __rt_exit

[Called By]

- >> __rt_entry_main

_sys_exit (Thumb, 8 bytes, Stack size 0 bytes, sys_exit.o(.text))

[Called By]

- >> __rt_exit_exit

__I$use$semihosting (Thumb, 0 bytes, Stack size 0 bytes, use_no_semi.o(.text), UNUSED)

__use_no_semihosting_swi (Thumb, 2 bytes, Stack size 0 bytes, use_no_semi.o(.text), UNUSED)

__semihosting_library_function (Thumb, 0 bytes, Stack size unknown bytes, indicate_semi.o(.text), UNUSED)

ADC_DMAConvCplt (Thumb, 98 bytes, Stack size 0 bytes, stm32g4xx_hal_adc.o(.text.ADC_DMAConvCplt))

[Calls]

- >> HAL_ADC_ConvCpltCallback
- >> HAL_ADC_ErrorCallback

[Address Reference Count : 1]

- stm32g4xx_hal_adc.o(.text.HAL_ADC_Start_DMA)

ADC_DMAError (Thumb, 22 bytes, Stack size 0 bytes, stm32g4xx_hal_adc.o(.text.ADC_DMAError))

[Calls]

- >> HAL_ADC_ErrorCallback

[Address Reference Count : 1]

- stm32g4xx_hal_adc.o(.text.HAL_ADC_Start_DMA)

ADC_DMAHalfConvCplt (Thumb, 6 bytes, Stack size 0 bytes, stm32g4xx_hal_adc.o(.text.ADC_DMAHalfConvCplt))

[Calls]

- >> HAL_ADC_ConvHalfCpltCallback

[Address Reference Count : 1]

- stm32g4xx_hal_adc.o(.text.HAL_ADC_Start_DMA)

ADC_Disable (Thumb, 124 bytes, Stack size 16 bytes, stm32g4xx_hal_adc.o(.text.ADC_Disable))

[Stack]

- Max Depth = 16
- Call Chain = ADC_Disable

[Calls]

- >> HAL_GetTick

[Called By]

- >> HAL_ADCEx_Calibration_Start

ADC_Enable (Thumb, 270 bytes, Stack size 24 bytes, stm32g4xx_hal_adc.o(.text.ADC_Enable))

[Stack]

- Max Depth = 24
- Call Chain = ADC_Enable

[Calls]

- >> HAL_GetTick

[Called By]

- >> HAL_ADC_Start_DMA
- >> HAL_ADC_Start

ADC_calculate (Thumb, 424 bytes, Stack size 24 bytes, function.o(.text.ADC_calculate))

[Stack]

- Max Depth = 168
- Call Chain = ADC_calculate ⇒ __hardfp_log ⇒ __kernel_poly ⇒ __aeabi_dmul

[Calls]

- >> HAL_ADC_GetValue
- >> HAL_ADC_Start
- >> __hardfp_log
- >> __aeabi_f2d
- >> __aeabi_ddiv
- >> __aeabi_dadd
- >> __aeabi_d2f

[Called By]

- >> main

Auto_FAN (Thumb, 328 bytes, Stack size 8 bytes, function.o(.text.Auto_FAN))

[Stack]

- Max Depth = 152
- Call Chain = Auto_FAN ⇒ __hardfp_log ⇒ __kernel_poly ⇒ __aeabi_dmul

[Calls]

- >> HAL_ADC_GetValue
- >> HAL_ADC_Start
- >> __hardfp_log
- >> __aeabi_f2d
- >> __aeabi_ddiv
- >> __aeabi_dadd
- >> __aeabi_d2f

[Called By]

- >> main

BUZZER_Middle (Thumb, 70 bytes, Stack size 16 bytes, function.o(.text.BUZZER_Middle))

[Stack]

- Max Depth = 16
- Call Chain = BUZZER_Middle

[Calls]

- >> HAL_GPIO_WritePin

[Called By]

- >> main

BUZZER_Short (Thumb, 76 bytes, Stack size 16 bytes, function.o(.text.BUZZER_Short))

[Stack]

- Max Depth = 16
- Call Chain = BUZZER_Short

[Calls]

- >> HAL_GPIO_WritePin

[Called By]

- >> main

BusFault_Handler (Thumb, 2 bytes, Stack size 0 bytes, stm32g4xx_it.o(.text.BusFault_Handler))

[Calls]

- >> BusFault_Handler

[Called By]

- >> BusFault_Handler

[Address Reference Count : 1]

- startup_stm32g474xx.o(RESET)

DMA1_Channel1_IRQHandler (Thumb, 12 bytes, Stack size 0 bytes, stm32g4xx_it.o(.text.DMA1_Channel1_IRQHandler))

[Stack]

- Max Depth = 16
- Call Chain = DMA1_Channel1_IRQHandler ⇒ HAL_DMA_IRQHandler

[Calls]

- >> HAL_DMA_IRQHandler

[Address Reference Count : 1]

- startup_stm32g474xx.o(RESET)

DMA1_Channel2_IRQHandler (Thumb, 12 bytes, Stack size 0 bytes, stm32g4xx_it.o(.text.DMA1_Channel2_IRQHandler))

[Stack]

- Max Depth = 16
- Call Chain = DMA1_Channel2_IRQHandler ⇒ HAL_DMA_IRQHandler

[Calls]

- >> HAL_DMA_IRQHandler

[Address Reference Count : 1]

- startup_stm32g474xx.o(RESET)

DMA1_Channel3_IRQHandler (Thumb, 12 bytes, Stack size 0 bytes, stm32g4xx_it.o(.text.DMA1_Channel3_IRQHandler))

[Stack]

- Max Depth = 16
- Call Chain = DMA1_Channel3_IRQHandler ⇒ HAL_DMA_IRQHandler

[Calls]

- >> HAL_DMA_IRQHandler

[Address Reference Count : 1]

- startup_stm32g474xx.o(RESET)

DebugMon_Handler (Thumb, 2 bytes, Stack size 0 bytes, stm32g4xx_it.o(.text.DebugMon_Handler))
[Address Reference Count : 1]

- startup_stm32g474xx.o(RESET)

EXTI0_IRQHandler (Thumb, 6 bytes, Stack size 0 bytes, stm32g4xx_it.o(.text.EXTI0_IRQHandler))

[Calls]

- >> HAL_GPIO_EXTI_IRQHandler

[Address Reference Count : 1]

- startup_stm32g474xx.o(RESET)

Encoder (Thumb, 3128 bytes, Stack size 24 bytes, function.o(.text.Encoder))

[Stack]

- Max Depth = 192 + Unknown Stack Size
- Call Chain = Encoder ⇒ USART1_Printf ⇒ vsnprintf ⇒ _printf_char_common ⇒ __printf

[Calls]

- >> HAL_GPIO_ReadPin
- >> HAL_Delay
- >> USART1_Printf
- >> __aeabi_f2d
- >> __aeabi_dcmplt
- >> __aeabi_dcmple
- >> __aeabi_dcmpge
- >> __aeabi_dcmpgt
- >> __aeabi_dadd
- >> __aeabi_d2f

[Called By]

- >> main

Error_Handler (Thumb, 10 bytes, Stack size 0 bytes, main.o(.text.Error_Handler))

[Called By]

- >> HAL_UART_MspInit
- >> MX_SPI3_Init
- >> MX_TIM4_Init
- >> MX_TIM3_Init
- >> MX_TIM8_Init
- >> MX_USART1_UART_Init
- >> MX_TIM2_Init
- >> MX_IWDG_Init
- >> HAL_I2C_MspInit
- >> MX_I2C3_Init
- >> MX_HRTIM1_Init
- >> HAL_ADC_MspInit
- >> MX_ADC5_Init
- >> MX_ADC2_Init
- >> MX_ADC1_Init

FAN_PWM_set (Thumb, 26 bytes, Stack size 0 bytes, function.o(.text.FAN_PWM_set))

[Called By]

- >> main

HAL_ADCEx_Calibration_Start (Thumb, 212 bytes, Stack size 24 bytes, stm32g4xx_hal_adc_ex.o(.text.HAL_ADCEx_Calibration_Start))

[Stack]

- Max Depth = 40
- Call Chain = HAL_ADCEx_Calibration_Start ⇒ ADC_Disable

[Calls]

- >> ADC_Disable

[Called By]

- >> main

HAL_ADCEx_MultiModeConfigChannel (Thumb, 308 bytes, Stack size 24 bytes, stm32g4xx_hal_adc_ex.o(.text.HAL_ADCEx_MultiModeConfigChannel))

[Stack]

- Max Depth = 24
- Call Chain = HAL_ADCEx_MultiModeConfigChannel

[Called By]

- >> MX_ADC1_Init

HAL_ADC_ConfigChannel (Thumb, 950 bytes, Stack size 24 bytes, stm32g4xx_hal_adc.o(.text.HAL_ADC_ConfigChannel))

[Stack]

- Max Depth = 24
- Call Chain = HAL_ADC_ConfigChannel

[Called By]

- >> MX_ADC5_Init
- >> MX_ADC2_Init
- >> MX_ADC1_Init

HAL_ADC_ConvCpltCallback (Thumb, 2 bytes, Stack size 0 bytes, stm32g4xx_hal_adc.o(.text.HAL_ADC_ConvCpltCallback))

[Called By]

- >> ADC_DMAConvCplt

HAL_ADC_ConvHalfCpltCallback (Thumb, 2 bytes, Stack size 0 bytes, stm32g4xx_hal_adc.o(.text.HAL_ADC_ConvHalfCpltCallback))

[Called By]

- >> ADC_DMAHalfConvCplt

HAL_ADC_ErrorCallback (Thumb, 2 bytes, Stack size 0 bytes, stm32g4xx_hal_adc.o(.text.HAL_ADC_ErrorCallback))

[Called By]

- >> ADC_DMAError
- >> ADC_DMAConvCplt

HAL_ADC_GetValue (Thumb, 6 bytes, Stack size 0 bytes, stm32g4xx_hal_adc.o(.text.HAL_ADC_GetValue))

[Called By]

- >> Auto_FAN
- >> OTP
- >> ADC_calculate

HAL_ADC_Init (Thumb, 636 bytes, Stack size 24 bytes, stm32g4xx_hal_adc.o(.text.HAL_ADC_Init))

[Stack]

- Max Depth = 196 + Unknown Stack Size
- Call Chain = HAL_ADC_Init ⇒ HAL_ADC_MspInit ⇒ HAL_GPIO_Init

[Calls]

- >> HAL_ADC_MspInit

[Called By]

- >> MX_ADC5_Init
- >> MX_ADC2_Init
- >> MX_ADC1_Init

HAL_ADC_MspInit (Thumb, 408 bytes, Stack size 128 bytes, adc.o(.text.HAL_ADC_MspInit))

[Stack]

- Max Depth = 172 + Unknown Stack Size
- Call Chain = HAL_ADC_MspInit ⇒ HAL_GPIO_Init

[Calls]

- >> HAL_DMA_Init
- >> HAL_GPIO_Init
- >> HAL_RCCEx_PeriphCLKConfig
- >> Error_Handler
- >> __aeabi_memclr4

[Called By]

- >> HAL_ADC_Init

HAL_ADC_Start (Thumb, 304 bytes, Stack size 16 bytes, stm32g4xx_hal_adc.o(.text.HAL_ADC_Start))

[Stack]

- Max Depth = 40
- Call Chain = HAL_ADC_Start ⇒ ADC_Enable

[Calls]

- >> ADC_Enable

[Called By]

- >> main
- >> Auto_FAN
- >> OTP
- >> ADC_calculate

HAL_ADC_Start_DMA (Thumb, 280 bytes, Stack size 24 bytes, stm32g4xx_hal_adc.o(.text.HAL_ADC_Start_DMA))

[Stack]

- Max Depth = 48
- Call Chain = HAL_ADC_Start_DMA ⇒ HAL_DMA_Start_IT

[Calls]

- >> HAL_DMA_Start_IT
- >> ADC_Enable

[Called By]

- >> main

HAL_DMA_Abort (Thumb, 112 bytes, Stack size 8 bytes, stm32g4xx_hal_dma.o(.text.HAL_DMA_Abort))

[Stack]

- Max Depth = 8
- Call Chain = HAL_DMA_Abort

[Called By]

- >> HAL_UART_IRQHandler

HAL_DMA_Abort_IT (Thumb, 128 bytes, Stack size 8 bytes, stm32g4xx_hal_dma.o(.text.HAL_DMA_Abort_IT))

[Stack]

- Max Depth = 8
- Call Chain = HAL_DMA_Abort_IT

[Called By]

- >> HAL_UART_IRQHandler

HAL_DMA_IRQHandler (Thumb, 170 bytes, Stack size 16 bytes, stm32g4xx_hal_dma.o(.text.HAL_DMA_IRQHandler))

[Stack]

- Max Depth = 16
- Call Chain = HAL_DMA_IRQHandler

[Called By]

- >> DMA1_Channel3_IRQHandler
- >> DMA1_Channel2_IRQHandler
- >> DMA1_Channel1_IRQHandler

HAL_DMA_Init (Thumb, 298 bytes, Stack size 32 bytes, stm32g4xx_hal_dma.o(.text.HAL_DMA_Init))

[Stack]

- Max Depth = 32
- Call Chain = HAL_DMA_Init

[Called By]

- >> HAL_UART_MspInit
- >> HAL_ADC_MspInit

HAL_DMA_Start_IT (Thumb, 232 bytes, Stack size 24 bytes, stm32g4xx_hal_dma.o(.text.HAL_DMA_Start_IT))

[Stack]

- Max Depth = 24
- Call Chain = HAL_DMA_Start_IT

[Called By]

- >> HAL_UART_Transmit_DMA
- >> HAL_ADC_Start_DMA

HAL_Delay (Thumb, 40 bytes, Stack size 16 bytes, stm32g4xx_hal.o(.text.HAL_Delay))

[Stack]

- Max Depth = 16
- Call Chain = HAL_Delay

[Calls]

- >> HAL_GetTick

[Called By]

- >> main
- >> Encoder

HAL_GPIO_EXTI_Callback (Thumb, 20 bytes, Stack size 0 bytes, function.o(.text.HAL_GPIO_EXTI_Callback))

[Called By]

- >> HAL_GPIO_EXTI_IRQHandler

HAL_GPIO_EXTI_IRQHandler (Thumb, 22 bytes, Stack size 0 bytes, stm32g4xx_hal_gpio.o(.text.HAL_GPIO_EXTI_IRQHandler))

[Calls]

- >> HAL_GPIO_EXTI_Callback

[Called By]

- >> EXTI0_IRQHandler

HAL_GPIO_Init (Thumb, 414 bytes, Stack size 44 bytes, stm32g4xx_hal_gpio.o(.text.HAL_GPIO_Init))

[Stack]

- Max Depth = 44
- Call Chain = HAL_GPIO_Init

[Called By]

- >> HAL_UART_MspInit
- >> HAL_SPI_MspInit
- >> MX_TIM8_Init
- >> HAL_I2C_MspInit
- >> MX_HRTIM1_Init
- >> MX_GPIO_Init
- >> HAL_ADC_MspInit

HAL_GPIO_ReadPin (Thumb, 10 bytes, Stack size 0 bytes, stm32g4xx_hal_gpio.o(.text.HAL_GPIO_ReadPin))

[Called By]

- >> HAL_TIM_PeriodElapsedCallback
- >> Encoder

HAL_GPIO_TogglePin (Thumb, 16 bytes, Stack size 0 bytes, stm32g4xx_hal_gpio.o(.text.HAL_GPIO_TogglePin))

[Called By]

- >> main

HAL_GPIO_WritePin (Thumb, 12 bytes, Stack size 0 bytes, stm32g4xx_hal_gpio.o(.text.HAL_GPIO_WritePin))

[Called By]

- >> main
- >> MX_GPIO_Init
- >> BUZZER_Middle
- >> BUZZER_Short
- >> StateM
- >> W25Q64_ReadData
- >> W25Q64_SectorErase
- >> W25Q64_PageProgram

HAL_GetTick (Thumb, 12 bytes, Stack size 0 bytes, stm32g4xx_hal.o(.text.HAL_GetTick))

[Called By]

- >> ADC_Enable
- >> ADC_Disable
- >> HAL_RCC_ClockConfig
- >> HAL_RCC_OscConfig
- >> HAL_IWDG_Init
- >> HAL_HRTIM_PollForDLLCalibration
- >> HAL_Delay
- >> HAL_RCCEx_PeriphCLKConfig
- >> HAL_SPI_TransmitReceive
- >> HAL_I2C_Master_Transmit
- >> SPI_WaitFlagStateUntilTimeout
- >> SPI_WaitFifoStateUntilTimeout
- >> I2C_WaitOnSTOPFlagUntilTimeout
- >> I2C_WaitOnFlagUntilTimeout
- >> I2C_WaitOnTXISFlagUntilTimeout
- >> I2C_IsErrorOccurred
- >> UART_WaitOnFlagUntilTimeout
- >> UART_CheckIdleState

HAL_HRTIM_ADCPostScalerConfig (Thumb, 334 bytes, Stack size 0 bytes, stm32g4xx_hal_hrtim.o(.text.HAL_HRTIM_ADCPostScalerConfig))

[Called By]

- >> MX_HRTIM1_Init

HAL_HRTIM_ADCTriggerConfig (Thumb, 670 bytes, Stack size 16 bytes, stm32g4xx_hal_hrtim.o(.text.HAL_HRTIM_ADCTriggerConfig))

[Stack]

- Max Depth = 16
- Call Chain = HAL_HRTIM_ADCTriggerConfig

[Called By]

- >> MX_HRTIM1_Init

HAL_HRTIM_BurstModePeriodCallback (Thumb, 2 bytes, Stack size 0 bytes, stm32g4xx_hal_hrtim.o(.text.HAL_HRTIM_BurstModePeriodCallback))

[Called By]

- >> HAL_HRTIM_IRQHandler

HAL_HRTIM_Capture1EventCallback (Thumb, 2 bytes, Stack size 0 bytes, stm32g4xx_hal_hrtim.o(.text.HAL_HRTIM_Capture1EventCallback))

[Called By]

- >> HAL_HRTIM_IRQHandler

HAL_HRTIM_Capture2EventCallback (Thumb, 2 bytes, Stack size 0 bytes, stm32g4xx_hal_hrtim.o(.text.HAL_HRTIM_Capture2EventCallback))

[Called By]

- >> HAL_HRTIM_IRQHandler

HAL_HRTIM_Compare1EventCallback (Thumb, 2 bytes, Stack size 0 bytes, stm32g4xx_hal_hrtim.o(.text.HAL_HRTIM_Compare1EventCallback))

[Called By]

- >> HAL_HRTIM_IRQHandler

HAL_HRTIM_Compare2EventCallback (Thumb, 2 bytes, Stack size 0 bytes, stm32g4xx_hal_hrtim.o(.text.HAL_HRTIM_Compare2EventCallback))

[Called By]

- >> HAL_HRTIM_IRQHandler

HAL_HRTIM_Compare3EventCallback (Thumb, 2 bytes, Stack size 0 bytes, stm32g4xx_hal_hrtim.o(.text.HAL_HRTIM_Compare3EventCallback))

[Called By]

- >> HAL_HRTIM_IRQHandler

HAL_HRTIM_Compare4EventCallback (Thumb, 2 bytes, Stack size 0 bytes, stm32g4xx_hal_hrtim.o(.text.HAL_HRTIM_Compare4EventCallback))

[Called By]

- >> HAL_HRTIM_IRQHandler

HAL_HRTIM_CounterResetCallback (Thumb, 2 bytes, Stack size 0 bytes, stm32g4xx_hal_hrtim.o(.text.HAL_HRTIM_CounterResetCallback))

[Called By]

- >> HAL_HRTIM_IRQHandler

HAL_HRTIM_DLLCalibrationReadyCallback (Thumb, 2 bytes, Stack size 0 bytes, stm32g4xx_hal_hrtim.o(.text.HAL_HRTIM_DLLCalibrationReadyCallback))

[Called By]

- >> HAL_HRTIM_IRQHandler

HAL_HRTIM_DLLCalibrationStart (Thumb, 84 bytes, Stack size 0 bytes, stm32g4xx_hal_hrtim.o(.text.HAL_HRTIM_DLLCalibrationStart))

[Called By]

- >> MX_HRTIM1_Init

HAL_HRTIM_DeadTimeConfig (Thumb, 152 bytes, Stack size 16 bytes, stm32g4xx_hal_hrtim.o(.text.HAL_HRTIM_DeadTimeConfig))

[Stack]

- Max Depth = 16
- Call Chain = HAL_HRTIM_DeadTimeConfig

[Called By]

- >> MX_HRTIM1_Init

HAL_HRTIM_DelayedProtectionCallback (Thumb, 2 bytes, Stack size 0 bytes, stm32g4xx_hal_hrtim.o(.text.HAL_HRTIM_DelayedProtectionCallback))

[Called By]

- >> HAL_HRTIM_IRQHandler

HAL_HRTIM_Fault1Callback (Thumb, 2 bytes, Stack size 0 bytes, stm32g4xx_hal_hrtim.o(.text.HAL_HRTIM_Fault1Callback))

[Called By]

- >> HAL_HRTIM_IRQHandler

HAL_HRTIM_Fault2Callback (Thumb, 2 bytes, Stack size 0 bytes, stm32g4xx_hal_hrtim.o(.text.HAL_HRTIM_Fault2Callback))

[Called By]

- >> HAL_HRTIM_IRQHandler

HAL_HRTIM_Fault3Callback (Thumb, 2 bytes, Stack size 0 bytes, stm32g4xx_hal_hrtim.o(.text.HAL_HRTIM_Fault3Callback))

[Called By]

- >> HAL_HRTIM_IRQHandler

HAL_HRTIM_Fault4Callback (Thumb, 2 bytes, Stack size 0 bytes, stm32g4xx_hal_hrtim.o(.text.HAL_HRTIM_Fault4Callback))

[Called By]

- >> HAL_HRTIM_IRQHandler

HAL_HRTIM_Fault5Callback (Thumb, 2 bytes, Stack size 0 bytes, stm32g4xx_hal_hrtim.o(.text.HAL_HRTIM_Fault5Callback))

[Called By]

- >> HAL_HRTIM_IRQHandler

HAL_HRTIM_Fault6Callback (Thumb, 2 bytes, Stack size 0 bytes, stm32g4xx_hal_hrtim.o(.text.HAL_HRTIM_Fault6Callback))

[Called By]

- >> HAL_HRTIM_IRQHandler

HAL_HRTIM_IRQHandler (Thumb, 936 bytes, Stack size 24 bytes, stm32g4xx_hal_hrtim.o(.text.HAL_HRTIM_IRQHandler))

[Stack]

- Max Depth = 24
- Call Chain = HAL_HRTIM_IRQHandler

[Calls]

- >> HAL_HRTIM_SystemFaultCallback
- >> HAL_HRTIM_Fault6Callback
- >> HAL_HRTIM_Fault5Callback
- >> HAL_HRTIM_Fault4Callback
- >> HAL_HRTIM_Fault3Callback
- >> HAL_HRTIM_Fault2Callback
- >> HAL_HRTIM_Fault1Callback
- >> HAL_HRTIM_BurstModePeriodCallback
- >> HAL_HRTIM_DLLCalibrationReadyCallback
- >> HAL_HRTIM_DelayedProtectionCallback
- >> HAL_HRTIM_CounterResetCallback
- >> HAL_HRTIM_Output2ResetCallback
- >> HAL_HRTIM_Output2SetCallback
- >> HAL_HRTIM_Output1ResetCallback
- >> HAL_HRTIM_Output1SetCallback
- >> HAL_HRTIM_Capture2EventCallback
- >> HAL_HRTIM_Capture1EventCallback
- >> HAL_HRTIM_RegistersUpdateCallback
- >> HAL_HRTIM_Compare4EventCallback
- >> HAL_HRTIM_Compare3EventCallback
- >> HAL_HRTIM_Compare2EventCallback
- >> HAL_HRTIM_Compare1EventCallback
- >> HAL_HRTIM_RepetitionEventCallback
- >> HAL_HRTIM_SynchronizationEventCallback

[Called By]

- >> HRTIM1_TIMD_IRQHandler

HAL_HRTIM_Init (Thumb, 238 bytes, Stack size 16 bytes, stm32g4xx_hal_hrtim.o(.text.HAL_HRTIM_Init))

[Stack]

- Max Depth = 40
- Call Chain = HAL_HRTIM_Init ⇒ HAL_HRTIM_MspInit ⇒ HAL_NVIC_SetPriority

[Calls]

- >> HAL_HRTIM_MspInit

[Called By]

- >> MX_HRTIM1_Init

HAL_HRTIM_MspInit (Thumb, 68 bytes, Stack size 16 bytes, hrtim.o(.text.HAL_HRTIM_MspInit))

[Stack]

- Max Depth = 24
- Call Chain = HAL_HRTIM_MspInit ⇒ HAL_NVIC_SetPriority

[Calls]

- >> HAL_NVIC_EnableIRQ
- >> HAL_NVIC_SetPriority

[Called By]

- >> HAL_HRTIM_Init

HAL_HRTIM_Output1ResetCallback (Thumb, 2 bytes, Stack size 0 bytes, stm32g4xx_hal_hrtim.o(.text.HAL_HRTIM_Output1ResetCallback))

[Called By]

- >> HAL_HRTIM_IRQHandler

HAL_HRTIM_Output1SetCallback (Thumb, 2 bytes, Stack size 0 bytes, stm32g4xx_hal_hrtim.o(.text.HAL_HRTIM_Output1SetCallback))

[Called By]

- >> HAL_HRTIM_IRQHandler

HAL_HRTIM_Output2ResetCallback (Thumb, 2 bytes, Stack size 0 bytes, stm32g4xx_hal_hrtim.o(.text.HAL_HRTIM_Output2ResetCallback))

[Called By]

- >> HAL_HRTIM_IRQHandler

HAL_HRTIM_Output2SetCallback (Thumb, 2 bytes, Stack size 0 bytes, stm32g4xx_hal_hrtim.o(.text.HAL_HRTIM_Output2SetCallback))

[Called By]

- >> HAL_HRTIM_IRQHandler

HAL_HRTIM_PollForDLLCalibration (Thumb, 114 bytes, Stack size 16 bytes, stm32g4xx_hal_hrtim.o(.text.HAL_HRTIM_PollForDLLCalibration))

[Stack]

- Max Depth = 16
- Call Chain = HAL_HRTIM_PollForDLLCalibration

[Calls]

- >> HAL_GetTick

[Called By]

- >> MX_HRTIM1_Init

HAL_HRTIM_RegistersUpdateCallback (Thumb, 2 bytes, Stack size 0 bytes, stm32g4xx_hal_hrtim.o(.text.HAL_HRTIM_RegistersUpdateCallback))

[Called By]

- >> HAL_HRTIM_IRQHandler

HAL_HRTIM_RepetitionEventCallback (Thumb, 2 bytes, Stack size 0 bytes, stm32g4xx_hal_hrtim.o(.text.HAL_HRTIM_RepetitionEventCallback))

[Called By]

- >> HAL_HRTIM_IRQHandler

HAL_HRTIM_SynchronizationEventCallback (Thumb, 2 bytes, Stack size 0 bytes, stm32g4xx_hal_hrtim.o(.text.HAL_HRTIM_SynchronizationEventCallback))

[Called By]

- >> HAL_HRTIM_IRQHandler

HAL_HRTIM_SystemFaultCallback (Thumb, 2 bytes, Stack size 0 bytes, stm32g4xx_hal_hrtim.o(.text.HAL_HRTIM_SystemFaultCallback))

[Called By]

- >> HAL_HRTIM_IRQHandler

HAL_HRTIM_TimeBaseConfig (Thumb, 116 bytes, Stack size 8 bytes, stm32g4xx_hal_hrtim.o(.text.HAL_HRTIM_TimeBaseConfig))

[Stack]

- Max Depth = 8
- Call Chain = HAL_HRTIM_TimeBaseConfig

[Called By]

- >> MX_HRTIM1_Init

HAL_HRTIM_WaveformCompareConfig (Thumb, 418 bytes, Stack size 8 bytes, stm32g4xx_hal_hrtim.o(.text.HAL_HRTIM_WaveformCompareConfig))

[Stack]

- Max Depth = 8
- Call Chain = HAL_HRTIM_WaveformCompareConfig

[Called By]

- >> MX_HRTIM1_Init

HAL_HRTIM_WaveformCountStart (Thumb, 40 bytes, Stack size 0 bytes, stm32g4xx_hal_hrtim.o(.text.HAL_HRTIM_WaveformCountStart))

[Called By]

- >> main

HAL_HRTIM_WaveformOutputConfig (Thumb, 58 bytes, Stack size 16 bytes, stm32g4xx_hal_hrtim.o(.text.HAL_HRTIM_WaveformOutputConfig))

[Stack]

- Max Depth = 40
- Call Chain = HAL_HRTIM_WaveformOutputConfig ⇒ HRTIM_OutputConfig

[Calls]

- >> HRTIM_OutputConfig

[Called By]

- >> MX_HRTIM1_Init

HAL_HRTIM_WaveformOutputStart (Thumb, 44 bytes, Stack size 0 bytes, stm32g4xx_hal_hrtim.o(.text.HAL_HRTIM_WaveformOutputStart))

[Called By]

- >> ShortOff
- >> StateMRise

HAL_HRTIM_WaveformOutputStop (Thumb, 44 bytes, Stack size 0 bytes, stm32g4xx_hal_hrtim.o(.text.HAL_HRTIM_WaveformOutputStop))

[Called By]

- >> OTP
- >> OCP
- >> OVP
- >> StateMRise
- >> StateM
- >> Key_Process

HAL_HRTIM_WaveformTimerConfig (Thumb, 696 bytes, Stack size 92 bytes, stm32g4xx_hal_hrtim.o(.text.HAL_HRTIM_WaveformTimerConfig))

[Stack]

- Max Depth = 92
- Call Chain = HAL_HRTIM_WaveformTimerConfig

[Called By]

- >> MX_HRTIM1_Init

HAL_HRTIM_WaveformTimerControl (Thumb, 160 bytes, Stack size 24 bytes, stm32g4xx_hal_hrtim.o(.text.HAL_HRTIM_WaveformTimerControl))

[Stack]

- Max Depth = 24
- Call Chain = HAL_HRTIM_WaveformTimerControl

[Called By]

- >> MX_HRTIM1_Init

HAL_I2CEx_ConfigAnalogFilter (Thumb, 74 bytes, Stack size 0 bytes, stm32g4xx_hal_i2c_ex.o(.text.HAL_I2CEx_ConfigAnalogFilter))

[Called By]

- >> MX_I2C3_Init

HAL_I2CEx_ConfigDigitalFilter (Thumb, 72 bytes, Stack size 0 bytes, stm32g4xx_hal_i2c_ex.o(.text.HAL_I2CEx_ConfigDigitalFilter))

[Called By]

- >> MX_I2C3_Init

HAL_I2C_Init (Thumb, 174 bytes, Stack size 8 bytes, stm32g4xx_hal_i2c.o(.text.HAL_I2C_Init))

[Stack]

- Max Depth = 188 + Unknown Stack Size
- Call Chain = HAL_I2C_Init ⇒ HAL_I2C_MspInit ⇒ HAL_GPIO_Init

[Calls]

- >> HAL_I2C_MspInit

[Called By]

- >> MX_I2C3_Init

HAL_I2C_Master_Transmit (Thumb, 452 bytes, Stack size 40 bytes, stm32g4xx_hal_i2c.o(.text.HAL_I2C_Master_Transmit))

[Stack]

- Max Depth = 80
- Call Chain = HAL_I2C_Master_Transmit ⇒ I2C_WaitOnFlagUntilTimeout ⇒ I2C_IsErrorOccurred

[Calls]

- >> HAL_GetTick
- >> I2C_WaitOnSTOPFlagUntilTimeout
- >> I2C_WaitOnFlagUntilTimeout
- >> I2C_WaitOnTXISFlagUntilTimeout
- >> I2C_IsErrorOccurred

[Called By]

- >> OLED_Update
- >> OLED_Init

HAL_I2C_MspInit (Thumb, 194 bytes, Stack size 136 bytes, i2c.o(.text.HAL_I2C_MspInit))

[Stack]

- Max Depth = 180 + Unknown Stack Size
- Call Chain = HAL_I2C_MspInit ⇒ HAL_GPIO_Init

[Calls]

- >> HAL_GPIO_Init
- >> HAL_RCCEx_PeriphCLKConfig
- >> Error_Handler
- >> __aeabi_memclr4

[Called By]

- >> HAL_I2C_Init

HAL_IWDG_Init (Thumb, 100 bytes, Stack size 16 bytes, stm32g4xx_hal_iwdg.o(.text.HAL_IWDG_Init))

[Stack]

- Max Depth = 16
- Call Chain = HAL_IWDG_Init

[Calls]

- >> HAL_GetTick

[Called By]

- >> MX_IWDG_Init

HAL_IWDG_Refresh (Thumb, 12 bytes, Stack size 0 bytes, stm32g4xx_hal_iwdg.o(.text.HAL_IWDG_Refresh))

[Called By]

- >> main

HAL_IncTick (Thumb, 26 bytes, Stack size 0 bytes, stm32g4xx_hal.o(.text.HAL_IncTick))

[Called By]

- >> SysTick_Handler

HAL_Init (Thumb, 30 bytes, Stack size 8 bytes, stm32g4xx_hal.o(.text.HAL_Init))

[Stack]

- Max Depth = 32
- Call Chain = HAL_Init ⇒ HAL_InitTick ⇒ HAL_NVIC_SetPriority

[Calls]

- >> HAL_InitTick
- >> HAL_NVIC_SetPriorityGrouping
- >> HAL_MspInit

[Called By]

- >> main

HAL_InitTick (Thumb, 76 bytes, Stack size 16 bytes, stm32g4xx_hal.o(.text.HAL_InitTick))

[Stack]

- Max Depth = 24
- Call Chain = HAL_InitTick ⇒ HAL_NVIC_SetPriority

[Calls]

- >> HAL_SYSTICK_Config
- >> HAL_NVIC_SetPriority

[Called By]

- >> HAL_RCC_ClockConfig
- >> HAL_RCC_OscConfig
- >> HAL_Init

HAL_MspInit (Thumb, 52 bytes, Stack size 8 bytes, stm32g4xx_hal_msp.o(.text.HAL_MspInit))

[Stack]

- Max Depth = 8
- Call Chain = HAL_MspInit

[Calls]

- >> HAL_PWREx_DisableUCPDDeadBattery

[Called By]

- >> HAL_Init

HAL_NVIC_EnableIRQ (Thumb, 34 bytes, Stack size 0 bytes, stm32g4xx_hal_cortex.o(.text.HAL_NVIC_EnableIRQ))

[Called By]

- >> HAL_UART_MspInit
- >> HAL_TIM_Base_MspInit
- >> HAL_HRTIM_MspInit
- >> MX_GPIO_Init
- >> MX_DMA_Init

HAL_NVIC_SetPriority (Thumb, 86 bytes, Stack size 8 bytes, stm32g4xx_hal_cortex.o(.text.HAL_NVIC_SetPriority))

[Stack]

- Max Depth = 8
- Call Chain = HAL_NVIC_SetPriority

[Called By]

- >> HAL_InitTick
- >> HAL_UART_MspInit
- >> HAL_TIM_Base_MspInit
- >> HAL_HRTIM_MspInit
- >> MX_GPIO_Init
- >> MX_DMA_Init

HAL_NVIC_SetPriorityGrouping (Thumb, 32 bytes, Stack size 0 bytes, stm32g4xx_hal_cortex.o(.text.HAL_NVIC_SetPriorityGrouping))

[Called By]

- >> HAL_Init

HAL_PWREx_ControlVoltageScaling (Thumb, 294 bytes, Stack size 0 bytes, stm32g4xx_hal_pwr_ex.o(.text.HAL_PWREx_ControlVoltageScaling))

[Called By]

- >> main

HAL_PWREx_DisableUCPDDeadBattery (Thumb, 18 bytes, Stack size 0 bytes, stm32g4xx_hal_pwr_ex.o(.text.HAL_PWREx_DisableUCPDDeadBattery))

[Called By]

- >> HAL_MspInit

HAL_RCCEx_PeriphCLKConfig (Thumb, 726 bytes, Stack size 32 bytes, stm32g4xx_hal_rcc_ex.o(.text.HAL_RCCEx_PeriphCLKConfig))

[Stack]

- Max Depth = 32
- Call Chain = HAL_RCCEx_PeriphCLKConfig

[Calls]

- >> HAL_GetTick

[Called By]

- >> HAL_UART_MspInit
- >> HAL_I2C_MspInit
- >> HAL_ADC_MspInit

HAL_RCC_CSSCallback (Thumb, 2 bytes, Stack size 0 bytes, stm32g4xx_hal_rcc.o(.text.HAL_RCC_CSSCallback))

[Called By]

- >> HAL_RCC_NMI_IRQHandler

HAL_RCC_ClockConfig (Thumb, 780 bytes, Stack size 32 bytes, stm32g4xx_hal_rcc.o(.text.HAL_RCC_ClockConfig))

[Stack]

- Max Depth = 56
- Call Chain = HAL_RCC_ClockConfig ⇒ HAL_InitTick ⇒ HAL_NVIC_SetPriority

[Calls]

- >> HAL_GetTick
- >> HAL_InitTick

[Called By]

- >> main

HAL_RCC_EnableCSS (Thumb, 18 bytes, Stack size 0 bytes, stm32g4xx_hal_rcc.o(.text.HAL_RCC_EnableCSS))

[Called By]

- >> main

HAL_RCC_GetPCLK1Freq (Thumb, 42 bytes, Stack size 0 bytes, stm32g4xx_hal_rcc.o(.text.HAL_RCC_GetPCLK1Freq))

[Called By]

- >> UART_SetConfig

HAL_RCC_GetPCLK2Freq (Thumb, 42 bytes, Stack size 0 bytes, stm32g4xx_hal_rcc.o(.text.HAL_RCC_GetPCLK2Freq))

[Called By]

- >> UART_SetConfig

HAL_RCC_GetSysClockFreq (Thumb, 130 bytes, Stack size 8 bytes, stm32g4xx_hal_rcc.o(.text.HAL_RCC_GetSysClockFreq))

[Stack]

- Max Depth = 8
- Call Chain = HAL_RCC_GetSysClockFreq

[Called By]

- >> UART_SetConfig

HAL_RCC_NMI_IRQHandler (Thumb, 30 bytes, Stack size 8 bytes, stm32g4xx_hal_rcc.o(.text.HAL_RCC_NMI_IRQHandler))

[Stack]

- Max Depth = 8
- Call Chain = HAL_RCC_NMI_IRQHandler

[Calls]

- >> HAL_RCC_CSSCallback

[Called By]

- >> NMI_Handler

HAL_RCC_OscConfig (Thumb, 1234 bytes, Stack size 32 bytes, stm32g4xx_hal_rcc.o(.text.HAL_RCC_OscConfig))

[Stack]

- Max Depth = 56
- Call Chain = HAL_RCC_OscConfig ⇒ HAL_InitTick ⇒ HAL_NVIC_SetPriority

[Calls]

- >> HAL_GetTick
- >> HAL_InitTick

[Called By]

- >> main

HAL_SPI_Init (Thumb, 228 bytes, Stack size 16 bytes, stm32g4xx_hal_spi.o(.text.HAL_SPI_Init))

[Stack]

- Max Depth = 92
- Call Chain = HAL_SPI_Init ⇒ HAL_SPI_MspInit ⇒ HAL_GPIO_Init

[Calls]

- >> HAL_SPI_MspInit

[Called By]

- >> MX_SPI3_Init

HAL_SPI_MspInit (Thumb, 108 bytes, Stack size 32 bytes, spi.o(.text.HAL_SPI_MspInit))

[Stack]

- Max Depth = 76
- Call Chain = HAL_SPI_MspInit ⇒ HAL_GPIO_Init

[Calls]

- >> HAL_GPIO_Init

[Called By]

- >> HAL_SPI_Init

HAL_SPI_TransmitReceive (Thumb, 778 bytes, Stack size 32 bytes, stm32g4xx_hal_spi.o(.text.HAL_SPI_TransmitReceive))

[Stack]

- Max Depth = 72
- Call Chain = HAL_SPI_TransmitReceive ⇒ SPI_WaitFifoStateUntilTimeout

[Calls]

- >> HAL_GetTick
- >> SPI_WaitFlagStateUntilTimeout
- >> SPI_WaitFifoStateUntilTimeout

[Called By]

- >> W25Q64_ReadData
- >> W25Q64_SectorErase
- >> W25Q64_PageProgram

HAL_SYSTICK_Config (Thumb, 44 bytes, Stack size 0 bytes, stm32g4xx_hal_cortex.o(.text.HAL_SYSTICK_Config))

[Called By]

- >> HAL_InitTick

HAL_TIMEx_Break2Callback (Thumb, 2 bytes, Stack size 0 bytes, stm32g4xx_hal_tim_ex.o(.text.HAL_TIMEx_Break2Callback))

[Called By]

- >> HAL_TIM_IRQHandler

HAL_TIMEx_BreakCallback (Thumb, 2 bytes, Stack size 0 bytes, stm32g4xx_hal_tim_ex.o(.text.HAL_TIMEx_BreakCallback))

[Called By]

- >> HAL_TIM_IRQHandler

HAL_TIMEx_CommutCallback (Thumb, 2 bytes, Stack size 0 bytes, stm32g4xx_hal_tim_ex.o(.text.HAL_TIMEx_CommutCallback))

[Called By]

- >> HAL_TIM_IRQHandler

HAL_TIMEx_ConfigBreakDeadTime (Thumb, 216 bytes, Stack size 16 bytes, stm32g4xx_hal_tim_ex.o(.text.HAL_TIMEx_ConfigBreakDeadTime))

[Stack]

- Max Depth = 16
- Call Chain = HAL_TIMEx_ConfigBreakDeadTime

[Called By]

- >> MX_TIM8_Init

HAL_TIMEx_DirectionChangeCallback (Thumb, 2 bytes, Stack size 0 bytes, stm32g4xx_hal_tim_ex.o(.text.HAL_TIMEx_DirectionChangeCallback))

[Called By]

- >> HAL_TIM_IRQHandler

HAL_TIMEx_EncoderIndexCallback (Thumb, 2 bytes, Stack size 0 bytes, stm32g4xx_hal_tim_ex.o(.text.HAL_TIMEx_EncoderIndexCallback))

[Called By]

- >> HAL_TIM_IRQHandler

HAL_TIMEx_IndexErrorCallback (Thumb, 2 bytes, Stack size 0 bytes, stm32g4xx_hal_tim_ex.o(.text.HAL_TIMEx_IndexErrorCallback))

[Called By]

- >> HAL_TIM_IRQHandler

HAL_TIMEx_MasterConfigSynchronization (Thumb, 226 bytes, Stack size 16 bytes, stm32g4xx_hal_tim_ex.o(.text.HAL_TIMEx_MasterConfigSynchronization))

[Stack]

- Max Depth = 16
- Call Chain = HAL_TIMEx_MasterConfigSynchronization

[Called By]

- >> MX_TIM4_Init
- >> MX_TIM3_Init
- >> MX_TIM8_Init
- >> MX_TIM2_Init

HAL_TIMEx_TransitionErrorCallback (Thumb, 2 bytes, Stack size 0 bytes, stm32g4xx_hal_tim_ex.o(.text.HAL_TIMEx_TransitionErrorCallback))

[Called By]

- >> HAL_TIM_IRQHandler

HAL_TIM_Base_Init (Thumb, 98 bytes, Stack size 8 bytes, stm32g4xx_hal_tim.o(.text.HAL_TIM_Base_Init))

[Stack]

- Max Depth = 32
- Call Chain = HAL_TIM_Base_Init ⇒ HAL_TIM_Base_MspInit ⇒ HAL_NVIC_SetPriority

[Calls]

- >> HAL_TIM_Base_MspInit
- >> TIM_Base_SetConfig

[Called By]

- >> MX_TIM4_Init
- >> MX_TIM3_Init
- >> MX_TIM8_Init
- >> MX_TIM2_Init

HAL_TIM_Base_MspInit (Thumb, 236 bytes, Stack size 16 bytes, tim.o(.text.HAL_TIM_Base_MspInit))

[Stack]

- Max Depth = 24
- Call Chain = HAL_TIM_Base_MspInit ⇒ HAL_NVIC_SetPriority

[Calls]

- >> HAL_NVIC_EnableIRQ
- >> HAL_NVIC_SetPriority

[Called By]

- >> HAL_TIM_Base_Init

HAL_TIM_Base_Start_IT (Thumb, 186 bytes, Stack size 0 bytes, stm32g4xx_hal_tim.o(.text.HAL_TIM_Base_Start_IT))

[Called By]

- >> MX_TIM2_Init
- >> main

HAL_TIM_ConfigClockSource (Thumb, 548 bytes, Stack size 8 bytes, stm32g4xx_hal_tim.o(.text.HAL_TIM_ConfigClockSource))

[Stack]

- Max Depth = 8
- Call Chain = HAL_TIM_ConfigClockSource

[Called By]

- >> MX_TIM4_Init
- >> MX_TIM3_Init
- >> MX_TIM8_Init
- >> MX_TIM2_Init

HAL_TIM_IC_CaptureCallback (Thumb, 2 bytes, Stack size 0 bytes, stm32g4xx_hal_tim.o(.text.HAL_TIM_IC_CaptureCallback))

[Called By]

- >> HAL_TIM_IRQHandler

HAL_TIM_IRQHandler (Thumb, 460 bytes, Stack size 24 bytes, stm32g4xx_hal_tim.o(.text.HAL_TIM_IRQHandler))

[Stack]

- Max Depth = 224 + Unknown Stack Size
- Call Chain = HAL_TIM_IRQHandler ⇒ HAL_TIM_PeriodElapsedCallback ⇒ Key_Process ⇒ USART1_Printf ⇒ vsnprintf ⇒ _printf_char_common ⇒ __printf

[Calls]

- >> HAL_TIM_PeriodElapsedCallback
- >> HAL_TIMEx_TransitionErrorCallback
- >> HAL_TIMEx_IndexErrorCallback
- >> HAL_TIMEx_DirectionChangeCallback
- >> HAL_TIMEx_EncoderIndexCallback
- >> HAL_TIMEx_CommutCallback
- >> HAL_TIM_TriggerCallback
- >> HAL_TIMEx_Break2Callback
- >> HAL_TIMEx_BreakCallback
- >> HAL_TIM_OC_DelayElapsedCallback
- >> HAL_TIM_IC_CaptureCallback
- >> HAL_TIM_PWM_PulseFinishedCallback

[Called By]

- >> TIM4_IRQHandler
- >> TIM3_IRQHandler
- >> TIM2_IRQHandler

HAL_TIM_OC_DelayElapsedCallback (Thumb, 2 bytes, Stack size 0 bytes, stm32g4xx_hal_tim.o(.text.HAL_TIM_OC_DelayElapsedCallback))

[Called By]

- >> HAL_TIM_IRQHandler

HAL_TIM_PWM_ConfigChannel (Thumb, 1036 bytes, Stack size 24 bytes, stm32g4xx_hal_tim.o(.text.HAL_TIM_PWM_ConfigChannel))

[Stack]

- Max Depth = 24
- Call Chain = HAL_TIM_PWM_ConfigChannel

[Called By]

- >> MX_TIM8_Init

HAL_TIM_PWM_Init (Thumb, 98 bytes, Stack size 8 bytes, stm32g4xx_hal_tim.o(.text.HAL_TIM_PWM_Init))

[Stack]

- Max Depth = 16
- Call Chain = HAL_TIM_PWM_Init ⇒ TIM_Base_SetConfig

[Calls]

- >> HAL_TIM_PWM_MspInit
- >> TIM_Base_SetConfig

[Called By]

- >> MX_TIM8_Init

HAL_TIM_PWM_MspInit (Thumb, 2 bytes, Stack size 0 bytes, stm32g4xx_hal_tim.o(.text.HAL_TIM_PWM_MspInit))

[Called By]

- >> HAL_TIM_PWM_Init

HAL_TIM_PWM_PulseFinishedCallback (Thumb, 2 bytes, Stack size 0 bytes, stm32g4xx_hal_tim.o(.text.HAL_TIM_PWM_PulseFinishedCallback))

[Called By]

- >> HAL_TIM_IRQHandler

HAL_TIM_PWM_Start (Thumb, 422 bytes, Stack size 0 bytes, stm32g4xx_hal_tim.o(.text.HAL_TIM_PWM_Start))

[Called By]

- >> main

HAL_TIM_PeriodElapsedCallback (Thumb, 166 bytes, Stack size 8 bytes, main.o(.text.HAL_TIM_PeriodElapsedCallback))

[Stack]

- Max Depth = 200 + Unknown Stack Size
- Call Chain = HAL_TIM_PeriodElapsedCallback ⇒ Key_Process ⇒ USART1_Printf ⇒ vsnprintf ⇒ _printf_char_common ⇒ __printf

[Calls]

- >> BBMode
- >> OTP
- >> OCP
- >> OVP
- >> ShortOff
- >> StateM
- >> ADCSample
- >> HAL_GPIO_ReadPin
- >> Key_Process
- >> KEY_Scan

[Called By]

- >> HAL_TIM_IRQHandler

HAL_TIM_TriggerCallback (Thumb, 2 bytes, Stack size 0 bytes, stm32g4xx_hal_tim.o(.text.HAL_TIM_TriggerCallback))

[Called By]

- >> HAL_TIM_IRQHandler

HAL_UARTEx_DisableFifoMode (Thumb, 54 bytes, Stack size 0 bytes, stm32g4xx_hal_uart_ex.o(.text.HAL_UARTEx_DisableFifoMode))

[Called By]

- >> MX_USART1_UART_Init

HAL_UARTEx_RxEventCallback (Thumb, 2 bytes, Stack size 0 bytes, stm32g4xx_hal_uart.o(.text.HAL_UARTEx_RxEventCallback))

[Called By]

- >> HAL_UART_IRQHandler

HAL_UARTEx_RxFifoFullCallback (Thumb, 2 bytes, Stack size 0 bytes, stm32g4xx_hal_uart_ex.o(.text.HAL_UARTEx_RxFifoFullCallback))

[Called By]

- >> HAL_UART_IRQHandler

HAL_UARTEx_SetRxFifoThreshold (Thumb, 144 bytes, Stack size 16 bytes, stm32g4xx_hal_uart_ex.o(.text.HAL_UARTEx_SetRxFifoThreshold))

[Stack]

- Max Depth = 16
- Call Chain = HAL_UARTEx_SetRxFifoThreshold

[Called By]

- >> MX_USART1_UART_Init

HAL_UARTEx_SetTxFifoThreshold (Thumb, 144 bytes, Stack size 16 bytes, stm32g4xx_hal_uart_ex.o(.text.HAL_UARTEx_SetTxFifoThreshold))

[Stack]

- Max Depth = 16
- Call Chain = HAL_UARTEx_SetTxFifoThreshold

[Called By]

- >> MX_USART1_UART_Init

HAL_UARTEx_TxFifoEmptyCallback (Thumb, 2 bytes, Stack size 0 bytes, stm32g4xx_hal_uart_ex.o(.text.HAL_UARTEx_TxFifoEmptyCallback))

[Called By]

- >> HAL_UART_IRQHandler

HAL_UARTEx_WakeupCallback (Thumb, 2 bytes, Stack size 0 bytes, stm32g4xx_hal_uart_ex.o(.text.HAL_UARTEx_WakeupCallback))

[Called By]

- >> HAL_UART_IRQHandler

HAL_UART_ErrorCallback (Thumb, 2 bytes, Stack size 0 bytes, stm32g4xx_hal_uart.o(.text.HAL_UART_ErrorCallback))

[Called By]

- >> HAL_UART_IRQHandler
- >> UART_DMAAbortOnError
- >> UART_DMAError

HAL_UART_IRQHandler (Thumb, 1588 bytes, Stack size 16 bytes, stm32g4xx_hal_uart.o(.text.HAL_UART_IRQHandler))

[Stack]

- Max Depth = 24
- Call Chain = HAL_UART_IRQHandler ⇒ HAL_DMA_Abort_IT

[Calls]

- >> HAL_DMA_Abort_IT
- >> HAL_DMA_Abort
- >> HAL_UART_TxCpltCallback
- >> HAL_UARTEx_RxFifoFullCallback
- >> HAL_UARTEx_TxFifoEmptyCallback
- >> HAL_UARTEx_RxEventCallback
- >> HAL_UARTEx_WakeupCallback
- >> HAL_UART_ErrorCallback

[Called By]

- >> USART1_IRQHandler

HAL_UART_Init (Thumb, 100 bytes, Stack size 8 bytes, stm32g4xx_hal_uart.o(.text.HAL_UART_Init))

[Stack]

- Max Depth = 180 + Unknown Stack Size
- Call Chain = HAL_UART_Init ⇒ HAL_UART_MspInit ⇒ HAL_GPIO_Init

[Calls]

- >> HAL_UART_MspInit
- >> UART_CheckIdleState
- >> UART_SetConfig
- >> UART_AdvFeatureConfig

[Called By]

- >> MX_USART1_UART_Init

HAL_UART_MspInit (Thumb, 272 bytes, Stack size 128 bytes, usart.o(.text.HAL_UART_MspInit))

[Stack]

- Max Depth = 172 + Unknown Stack Size
- Call Chain = HAL_UART_MspInit ⇒ HAL_GPIO_Init

[Calls]

- >> HAL_NVIC_EnableIRQ
- >> HAL_NVIC_SetPriority
- >> HAL_DMA_Init
- >> HAL_GPIO_Init
- >> HAL_RCCEx_PeriphCLKConfig
- >> Error_Handler
- >> __aeabi_memclr4

[Called By]

- >> HAL_UART_Init

HAL_UART_Transmit_DMA (Thumb, 206 bytes, Stack size 16 bytes, stm32g4xx_hal_uart.o(.text.HAL_UART_Transmit_DMA))

[Stack]

- Max Depth = 40
- Call Chain = HAL_UART_Transmit_DMA ⇒ HAL_DMA_Start_IT

[Calls]

- >> HAL_DMA_Start_IT

[Called By]

- >> USART1_Printf

HAL_UART_TxCpltCallback (Thumb, 30 bytes, Stack size 0 bytes, usart.o(.text.HAL_UART_TxCpltCallback))

[Called By]

- >> HAL_UART_IRQHandler
- >> UART_DMATransmitCplt

HAL_UART_TxHalfCpltCallback (Thumb, 2 bytes, Stack size 0 bytes, stm32g4xx_hal_uart.o(.text.HAL_UART_TxHalfCpltCallback))

[Called By]

- >> UART_DMATxHalfCplt

HRTIM1_TIMD_IRQHandler (Thumb, 24 bytes, Stack size 8 bytes, stm32g4xx_it.o(.text.HRTIM1_TIMD_IRQHandler))

[Stack]

- Max Depth = 32
- Call Chain = HRTIM1_TIMD_IRQHandler ⇒ HAL_HRTIM_IRQHandler

[Calls]

- >> HAL_HRTIM_IRQHandler
- >> BuckBoostVILoopCtlPID

[Address Reference Count : 1]

- startup_stm32g474xx.o(RESET)

HardFault_Handler (Thumb, 2 bytes, Stack size 0 bytes, stm32g4xx_it.o(.text.HardFault_Handler))

[Calls]

- >> HardFault_Handler

[Called By]

- >> HardFault_Handler

[Address Reference Count : 1]

- startup_stm32g474xx.o(RESET)

Init_Flash (Thumb, 92 bytes, Stack size 40 bytes, function.o(.text.Init_Flash))

[Stack]

- Max Depth = 176
- Call Chain = Init_Flash ⇒ W25Q64_ReadData ⇒ HAL_SPI_TransmitReceive ⇒ SPI_WaitFifoStateUntilTimeout

[Calls]

- >> W25Q64_ReadData
- >> W25Q64_SectorErase
- >> W25Q64_PageProgram

[Called By]

- >> main

KEY_Scan (Thumb, 146 bytes, Stack size 8 bytes, Key.o(.text.KEY_Scan))

[Stack]

- Max Depth = 8
- Call Chain = KEY_Scan

[Called By]

- >> HAL_TIM_PeriodElapsedCallback

Key_Init (Thumb, 22 bytes, Stack size 0 bytes, Key.o(.text.Key_Init))

[Called By]

- >> main

Key_Process (Thumb, 372 bytes, Stack size 24 bytes, function.o(.text.Key_Process))

[Stack]

- Max Depth = 192 + Unknown Stack Size
- Call Chain = Key_Process ⇒ USART1_Printf ⇒ vsnprintf ⇒ _printf_char_common ⇒ __printf

[Calls]

- >> HAL_HRTIM_WaveformOutputStop
- >> USART1_Printf

[Called By]

- >> HAL_TIM_PeriodElapsedCallback

MX_ADC1_Init (Thumb, 300 bytes, Stack size 56 bytes, adc.o(.text.MX_ADC1_Init))

[Stack]

- Max Depth = 252 + Unknown Stack Size
- Call Chain = MX_ADC1_Init ⇒ HAL_ADC_Init ⇒ HAL_ADC_MspInit ⇒ HAL_GPIO_Init

[Calls]

- >> HAL_ADC_ConfigChannel
- >> HAL_ADCEx_MultiModeConfigChannel
- >> Error_Handler
- >> HAL_ADC_Init

[Called By]

- >> main

MX_ADC2_Init (Thumb, 160 bytes, Stack size 48 bytes, adc.o(.text.MX_ADC2_Init))

[Stack]

- Max Depth = 244 + Unknown Stack Size
- Call Chain = MX_ADC2_Init ⇒ HAL_ADC_Init ⇒ HAL_ADC_MspInit ⇒ HAL_GPIO_Init

[Calls]

- >> HAL_ADC_ConfigChannel
- >> Error_Handler
- >> HAL_ADC_Init

[Called By]

- >> main

MX_ADC5_Init (Thumb, 160 bytes, Stack size 48 bytes, adc.o(.text.MX_ADC5_Init))

[Stack]

- Max Depth = 244 + Unknown Stack Size
- Call Chain = MX_ADC5_Init ⇒ HAL_ADC_Init ⇒ HAL_ADC_MspInit ⇒ HAL_GPIO_Init

[Calls]

- >> HAL_ADC_ConfigChannel
- >> Error_Handler
- >> HAL_ADC_Init

[Called By]

- >> main

MX_DMA_Init (Thumb, 102 bytes, Stack size 16 bytes, dma.o(.text.MX_DMA_Init))

[Stack]

- Max Depth = 24
- Call Chain = MX_DMA_Init ⇒ HAL_NVIC_SetPriority

[Calls]

- >> HAL_NVIC_EnableIRQ
- >> HAL_NVIC_SetPriority

[Called By]

- >> main

MX_GPIO_Init (Thumb, 294 bytes, Stack size 64 bytes, gpio.o(.text.MX_GPIO_Init))

[Stack]

- Max Depth = 108
- Call Chain = MX_GPIO_Init ⇒ HAL_GPIO_Init

[Calls]

- >> HAL_NVIC_EnableIRQ
- >> HAL_NVIC_SetPriority
- >> HAL_GPIO_Init
- >> HAL_GPIO_WritePin

[Called By]

- >> main

MX_HRTIM1_Init (Thumb, 908 bytes, Stack size 280 bytes, hrtim.o(.text.MX_HRTIM1_Init))

[Stack]

- Max Depth = 372 + Unknown Stack Size
- Call Chain = MX_HRTIM1_Init ⇒ HAL_HRTIM_WaveformTimerConfig

[Calls]

- >> HAL_HRTIM_WaveformOutputConfig
- >> HAL_HRTIM_DeadTimeConfig
- >> HAL_HRTIM_WaveformCompareConfig
- >> HAL_HRTIM_WaveformTimerConfig
- >> HAL_HRTIM_WaveformTimerControl
- >> HAL_HRTIM_TimeBaseConfig
- >> HAL_HRTIM_ADCPostScalerConfig
- >> HAL_HRTIM_ADCTriggerConfig
- >> HAL_HRTIM_PollForDLLCalibration
- >> HAL_HRTIM_DLLCalibrationStart
- >> HAL_HRTIM_Init
- >> HAL_GPIO_Init
- >> Error_Handler
- >> __aeabi_memclr4

[Called By]

- >> main

MX_I2C3_Init (Thumb, 118 bytes, Stack size 8 bytes, i2c.o(.text.MX_I2C3_Init))

[Stack]

- Max Depth = 196 + Unknown Stack Size
- Call Chain = MX_I2C3_Init ⇒ HAL_I2C_Init ⇒ HAL_I2C_MspInit ⇒ HAL_GPIO_Init

[Calls]

- >> HAL_I2CEx_ConfigDigitalFilter
- >> HAL_I2CEx_ConfigAnalogFilter
- >> HAL_I2C_Init
- >> Error_Handler

[Called By]

- >> main

MX_IWDG_Init (Thumb, 48 bytes, Stack size 8 bytes, iwdg.o(.text.MX_IWDG_Init))

[Stack]

- Max Depth = 24
- Call Chain = MX_IWDG_Init ⇒ HAL_IWDG_Init

[Calls]

- >> HAL_IWDG_Init
- >> Error_Handler

[Called By]

- >> main

MX_SPI3_Init (Thumb, 80 bytes, Stack size 8 bytes, spi.o(.text.MX_SPI3_Init))

[Stack]

- Max Depth = 100
- Call Chain = MX_SPI3_Init ⇒ HAL_SPI_Init ⇒ HAL_SPI_MspInit ⇒ HAL_GPIO_Init

[Calls]

- >> HAL_SPI_Init
- >> Error_Handler

[Called By]

- >> main

MX_TIM2_Init (Thumb, 130 bytes, Stack size 40 bytes, tim.o(.text.MX_TIM2_Init))

[Stack]

- Max Depth = 72
- Call Chain = MX_TIM2_Init ⇒ HAL_TIM_Base_Init ⇒ HAL_TIM_Base_MspInit ⇒ HAL_NVIC_SetPriority

[Calls]

- >> HAL_TIMEx_MasterConfigSynchronization
- >> HAL_TIM_ConfigClockSource
- >> HAL_TIM_Base_Init
- >> HAL_TIM_Base_Start_IT
- >> Error_Handler

[Called By]

- >> main

MX_TIM3_Init (Thumb, 122 bytes, Stack size 40 bytes, tim.o(.text.MX_TIM3_Init))

[Stack]

- Max Depth = 72
- Call Chain = MX_TIM3_Init ⇒ HAL_TIM_Base_Init ⇒ HAL_TIM_Base_MspInit ⇒ HAL_NVIC_SetPriority

[Calls]

- >> HAL_TIMEx_MasterConfigSynchronization
- >> HAL_TIM_ConfigClockSource
- >> HAL_TIM_Base_Init
- >> Error_Handler

[Called By]

- >> main

MX_TIM4_Init (Thumb, 122 bytes, Stack size 40 bytes, tim.o(.text.MX_TIM4_Init))

[Stack]

- Max Depth = 72
- Call Chain = MX_TIM4_Init ⇒ HAL_TIM_Base_Init ⇒ HAL_TIM_Base_MspInit ⇒ HAL_NVIC_SetPriority

[Calls]

- >> HAL_TIMEx_MasterConfigSynchronization
- >> HAL_TIM_ConfigClockSource
- >> HAL_TIM_Base_Init
- >> Error_Handler

[Called By]

- >> main

MX_TIM8_Init (Thumb, 350 bytes, Stack size 144 bytes, tim.o(.text.MX_TIM8_Init))

[Stack]

- Max Depth = 188 + Unknown Stack Size
- Call Chain = MX_TIM8_Init ⇒ HAL_GPIO_Init

[Calls]

- >> HAL_TIMEx_ConfigBreakDeadTime
- >> HAL_TIM_PWM_ConfigChannel
- >> HAL_TIM_PWM_Init
- >> HAL_TIMEx_MasterConfigSynchronization
- >> HAL_TIM_ConfigClockSource
- >> HAL_TIM_Base_Init
- >> HAL_GPIO_Init
- >> Error_Handler
- >> __aeabi_memclr4

[Called By]

- >> main

MX_USART1_UART_Init (Thumb, 130 bytes, Stack size 8 bytes, usart.o(.text.MX_USART1_UART_Init))

[Stack]

- Max Depth = 188 + Unknown Stack Size
- Call Chain = MX_USART1_UART_Init ⇒ HAL_UART_Init ⇒ HAL_UART_MspInit ⇒ HAL_GPIO_Init

[Calls]

- >> HAL_UARTEx_DisableFifoMode
- >> HAL_UARTEx_SetRxFifoThreshold
- >> HAL_UARTEx_SetTxFifoThreshold
- >> HAL_UART_Init
- >> Error_Handler

[Called By]

- >> main

MemManage_Handler (Thumb, 2 bytes, Stack size 0 bytes, stm32g4xx_it.o(.text.MemManage_Handler))

[Calls]

- >> MemManage_Handler

[Called By]

- >> MemManage_Handler

[Address Reference Count : 1]

- startup_stm32g474xx.o(RESET)

NMI_Handler (Thumb, 6 bytes, Stack size 0 bytes, stm32g4xx_it.o(.text.NMI_Handler))

[Stack]

- Max Depth = 8
- Call Chain = NMI_Handler ⇒ HAL_RCC_NMI_IRQHandler

[Calls]

- >> HAL_RCC_NMI_IRQHandler

[Address Reference Count : 1]

- startup_stm32g474xx.o(RESET)

OCP (Thumb, 256 bytes, Stack size 16 bytes, function.o(.text.OCP))

[Stack]

- Max Depth = 16
- Call Chain = OCP

[Calls]

- >> HAL_HRTIM_WaveformOutputStop

[Called By]

- >> HAL_TIM_PeriodElapsedCallback

OLED_Clear (Thumb, 1066 bytes, Stack size 0 bytes, OLED.o(.text.OLED_Clear))

[Called By]

- >> main
- >> OLED_Display

OLED_Display (Thumb, 2388 bytes, Stack size 48 bytes, function.o(.text.OLED_Display))

[Stack]

- Max Depth = 304 + Unknown Stack Size
- Call Chain = OLED_Display ⇒ OLED_Update ⇒ HAL_I2C_Master_Transmit ⇒ I2C_WaitOnFlagUntilTimeout ⇒ I2C_IsErrorOccurred

[Calls]

- >> OLED_DrawCircle
- >> OLED_Printf
- >> OLED_ShowChinese
- >> OLED_ShowNum
- >> OLED_ShowString
- >> OLED_ShowChar
- >> OLED_ReverseArea
- >> OLED_Clear
- >> OLED_Update
- >> __aeabi_f2d

[Called By]

- >> main

OLED_DrawCircle (Thumb, 2086 bytes, Stack size 84 bytes, OLED.o(.text.OLED_DrawCircle))

[Stack]

- Max Depth = 84
- Call Chain = OLED_DrawCircle

[Called By]

- >> OLED_Display

OLED_Init (Thumb, 1686 bytes, Stack size 32 bytes, OLED.o(.text.OLED_Init))

[Stack]

- Max Depth = 288
- Call Chain = OLED_Init ⇒ OLED_Update ⇒ HAL_I2C_Master_Transmit ⇒ I2C_WaitOnFlagUntilTimeout ⇒ I2C_IsErrorOccurred

[Calls]

- >> OLED_Update
- >> HAL_I2C_Master_Transmit

[Called By]

- >> main

OLED_Printf (Thumb, 216 bytes, Stack size 72 bytes, OLED.o(.text.OLED_Printf))

[Stack]

- Max Depth = 192 + Unknown Stack Size
- Call Chain = OLED_Printf ⇒ vsprintf ⇒ _printf_char_common ⇒ __printf

[Calls]

- >> OLED_ShowImage
- >> vsprintf

[Called By]

- >> OLED_Display

OLED_ReverseArea (Thumb, 200 bytes, Stack size 32 bytes, OLED.o(.text.OLED_ReverseArea))

[Stack]

- Max Depth = 32
- Call Chain = OLED_ReverseArea

[Called By]

- >> OLED_Display

OLED_ShowChar (Thumb, 80 bytes, Stack size 16 bytes, OLED.o(.text.OLED_ShowChar))

[Stack]

- Max Depth = 64
- Call Chain = OLED_ShowChar ⇒ OLED_ShowImage

[Calls]

- >> OLED_ShowImage

[Called By]

- >> OLED_Display

OLED_ShowChinese (Thumb, 194 bytes, Stack size 48 bytes, OLED.o(.text.OLED_ShowChinese))

[Stack]

- Max Depth = 96
- Call Chain = OLED_ShowChinese ⇒ OLED_ShowImage

[Calls]

- >> OLED_ShowImage
- >> strcmp

[Called By]

- >> main
- >> OLED_Display

OLED_ShowImage (Thumb, 490 bytes, Stack size 48 bytes, OLED.o(.text.OLED_ShowImage))

[Stack]

- Max Depth = 48
- Call Chain = OLED_ShowImage

[Called By]

- >> OLED_Printf
- >> OLED_ShowChinese
- >> OLED_ShowNum
- >> OLED_ShowString
- >> OLED_ShowChar

OLED_ShowNum (Thumb, 396 bytes, Stack size 48 bytes, OLED.o(.text.OLED_ShowNum))

[Stack]

- Max Depth = 96
- Call Chain = OLED_ShowNum ⇒ OLED_ShowImage

[Calls]

- >> OLED_ShowImage

[Called By]

- >> OLED_Display

OLED_ShowString (Thumb, 192 bytes, Stack size 32 bytes, OLED.o(.text.OLED_ShowString))

[Stack]

- Max Depth = 80
- Call Chain = OLED_ShowString ⇒ OLED_ShowImage

[Calls]

- >> OLED_ShowImage

[Called By]

- >> OLED_Display

OLED_Update (Thumb, 162 bytes, Stack size 176 bytes, OLED.o(.text.OLED_Update))

[Stack]

- Max Depth = 256
- Call Chain = OLED_Update ⇒ HAL_I2C_Master_Transmit ⇒ I2C_WaitOnFlagUntilTimeout ⇒ I2C_IsErrorOccurred

[Calls]

- >> HAL_I2C_Master_Transmit
- >> __aeabi_memcpy

[Called By]

- >> main
- >> OLED_Display
- >> OLED_Init

OTP (Thumb, 232 bytes, Stack size 16 bytes, function.o(.text.OTP))

[Stack]

- Max Depth = 160
- Call Chain = OTP ⇒ __hardfp_log ⇒ __kernel_poly ⇒ __aeabi_dmul

[Calls]

- >> HAL_ADC_GetValue
- >> HAL_ADC_Start
- >> HAL_HRTIM_WaveformOutputStop
- >> __hardfp_log
- >> __aeabi_f2d
- >> __aeabi_ddiv
- >> __aeabi_dadd
- >> __aeabi_d2f

[Called By]

- >> HAL_TIM_PeriodElapsedCallback

OVP (Thumb, 140 bytes, Stack size 16 bytes, function.o(.text.OVP))

[Stack]

- Max Depth = 16
- Call Chain = OVP

[Calls]

- >> HAL_HRTIM_WaveformOutputStop

[Called By]

- >> HAL_TIM_PeriodElapsedCallback

PID_Init (Thumb, 26 bytes, Stack size 0 bytes, PID.o(.text.PID_Init))

[Called By]

- >> main

PendSV_Handler (Thumb, 2 bytes, Stack size 0 bytes, stm32g4xx_it.o(.text.PendSV_Handler))
[Address Reference Count : 1]

- startup_stm32g474xx.o(RESET)

Read_Flash (Thumb, 56 bytes, Stack size 32 bytes, function.o(.text.Read_Flash))

[Stack]

- Max Depth = 168
- Call Chain = Read_Flash ⇒ W25Q64_ReadData ⇒ HAL_SPI_TransmitReceive ⇒ SPI_WaitFifoStateUntilTimeout

[Calls]

- >> W25Q64_ReadData

[Called By]

- >> main

SVC_Handler (Thumb, 2 bytes, Stack size 0 bytes, stm32g4xx_it.o(.text.SVC_Handler))
[Address Reference Count : 1]

- startup_stm32g474xx.o(RESET)

ShortOff (Thumb, 252 bytes, Stack size 16 bytes, function.o(.text.ShortOff))

[Stack]

- Max Depth = 16
- Call Chain = ShortOff

[Calls]

- >> HAL_HRTIM_WaveformOutputStart

[Called By]

- >> HAL_TIM_PeriodElapsedCallback

StateMRise (Thumb, 516 bytes, Stack size 16 bytes, function.o(.text.StateMRise))

[Stack]

- Max Depth = 16
- Call Chain = StateMRise

[Calls]

- >> HAL_HRTIM_WaveformOutputStart
- >> HAL_HRTIM_WaveformOutputStop

[Called By]

- >> StateM

SysTick_Handler (Thumb, 4 bytes, Stack size 0 bytes, stm32g4xx_it.o(.text.SysTick_Handler))

[Calls]

- >> HAL_IncTick

[Address Reference Count : 1]

- startup_stm32g474xx.o(RESET)

SystemInit (Thumb, 18 bytes, Stack size 0 bytes, system_stm32g4xx.o(.text.SystemInit))
[Address Reference Count : 1]

- startup_stm32g474xx.o(.text)

TIM2_IRQHandler (Thumb, 12 bytes, Stack size 0 bytes, stm32g4xx_it.o(.text.TIM2_IRQHandler))

[Stack]

- Max Depth = 224 + Unknown Stack Size
- Call Chain = TIM2_IRQHandler ⇒ HAL_TIM_IRQHandler ⇒ HAL_TIM_PeriodElapsedCallback ⇒ Key_Process ⇒ USART1_Printf ⇒ vsnprintf ⇒ _printf_char_common ⇒ __printf

[Calls]

- >> HAL_TIM_IRQHandler

[Address Reference Count : 1]

- startup_stm32g474xx.o(RESET)

TIM3_IRQHandler (Thumb, 12 bytes, Stack size 0 bytes, stm32g4xx_it.o(.text.TIM3_IRQHandler))

[Stack]

- Max Depth = 224 + Unknown Stack Size
- Call Chain = TIM3_IRQHandler ⇒ HAL_TIM_IRQHandler ⇒ HAL_TIM_PeriodElapsedCallback ⇒ Key_Process ⇒ USART1_Printf ⇒ vsnprintf ⇒ _printf_char_common ⇒ __printf

[Calls]

- >> HAL_TIM_IRQHandler

[Address Reference Count : 1]

- startup_stm32g474xx.o(RESET)

TIM4_IRQHandler (Thumb, 12 bytes, Stack size 0 bytes, stm32g4xx_it.o(.text.TIM4_IRQHandler))

[Stack]

- Max Depth = 224 + Unknown Stack Size
- Call Chain = TIM4_IRQHandler ⇒ HAL_TIM_IRQHandler ⇒ HAL_TIM_PeriodElapsedCallback ⇒ Key_Process ⇒ USART1_Printf ⇒ vsnprintf ⇒ _printf_char_common ⇒ __printf

[Calls]

- >> HAL_TIM_IRQHandler

[Address Reference Count : 1]

- startup_stm32g474xx.o(RESET)

TIM_Base_SetConfig (Thumb, 336 bytes, Stack size 8 bytes, stm32g4xx_hal_tim.o(.text.TIM_Base_SetConfig))

[Stack]

- Max Depth = 8
- Call Chain = TIM_Base_SetConfig

[Called By]

- >> HAL_TIM_PWM_Init
- >> HAL_TIM_Base_Init

UART_AdvFeatureConfig (Thumb, 234 bytes, Stack size 8 bytes, stm32g4xx_hal_uart.o(.text.UART_AdvFeatureConfig))

[Stack]

- Max Depth = 8
- Call Chain = UART_AdvFeatureConfig

[Called By]

- >> HAL_UART_Init

UART_CheckIdleState (Thumb, 366 bytes, Stack size 24 bytes, stm32g4xx_hal_uart.o(.text.UART_CheckIdleState))

[Stack]

- Max Depth = 48
- Call Chain = UART_CheckIdleState ⇒ UART_WaitOnFlagUntilTimeout

[Calls]

- >> HAL_GetTick
- >> UART_WaitOnFlagUntilTimeout

[Called By]

- >> HAL_UART_Init

UART_SetConfig (Thumb, 676 bytes, Stack size 16 bytes, stm32g4xx_hal_uart.o(.text.UART_SetConfig))

[Stack]

- Max Depth = 64
- Call Chain = UART_SetConfig ⇒ __aeabi_uldivmod

[Calls]

- >> HAL_RCC_GetPCLK2Freq
- >> HAL_RCC_GetPCLK1Freq
- >> HAL_RCC_GetSysClockFreq
- >> __aeabi_uldivmod

[Called By]

- >> HAL_UART_Init

UART_WaitOnFlagUntilTimeout (Thumb, 822 bytes, Stack size 24 bytes, stm32g4xx_hal_uart.o(.text.UART_WaitOnFlagUntilTimeout))

[Stack]

- Max Depth = 24
- Call Chain = UART_WaitOnFlagUntilTimeout

[Calls]

- >> HAL_GetTick

[Called By]

- >> UART_CheckIdleState

USART1_IRQHandler (Thumb, 12 bytes, Stack size 0 bytes, stm32g4xx_it.o(.text.USART1_IRQHandler))

[Stack]

- Max Depth = 24
- Call Chain = USART1_IRQHandler ⇒ HAL_UART_IRQHandler ⇒ HAL_DMA_Abort_IT

[Calls]

- >> HAL_UART_IRQHandler

[Address Reference Count : 1]

- startup_stm32g474xx.o(RESET)

USART1_Printf (Thumb, 188 bytes, Stack size 40 bytes, usart.o(.text.USART1_Printf))

[Stack]

- Max Depth = 168 + Unknown Stack Size
- Call Chain = USART1_Printf ⇒ vsnprintf ⇒ _printf_char_common ⇒ __printf

[Calls]

- >> HAL_UART_Transmit_DMA
- >> vsnprintf

[Called By]

- >> main
- >> Encoder
- >> Key_Process

Update_Flash (Thumb, 94 bytes, Stack size 48 bytes, function.o(.text.Update_Flash))

[Stack]

- Max Depth = 176
- Call Chain = Update_Flash ⇒ W25Q64_SectorErase ⇒ HAL_SPI_TransmitReceive ⇒ SPI_WaitFifoStateUntilTimeout

[Calls]

- >> W25Q64_SectorErase
- >> W25Q64_PageProgram

[Called By]

- >> main

UsageFault_Handler (Thumb, 2 bytes, Stack size 0 bytes, stm32g4xx_it.o(.text.UsageFault_Handler))

[Calls]

- >> UsageFault_Handler

[Called By]

- >> UsageFault_Handler

[Address Reference Count : 1]

- startup_stm32g474xx.o(RESET)

W25Q64_PageProgram (Thumb, 420 bytes, Stack size 56 bytes, W25Q64.o(.text.W25Q64_PageProgram))

[Stack]

- Max Depth = 128
- Call Chain = W25Q64_PageProgram ⇒ HAL_SPI_TransmitReceive ⇒ SPI_WaitFifoStateUntilTimeout

[Calls]

- >> HAL_SPI_TransmitReceive
- >> HAL_GPIO_WritePin

[Called By]

- >> Update_Flash
- >> Init_Flash

W25Q64_ReadData (Thumb, 378 bytes, Stack size 64 bytes, W25Q64.o(.text.W25Q64_ReadData))

[Stack]

- Max Depth = 136
- Call Chain = W25Q64_ReadData ⇒ HAL_SPI_TransmitReceive ⇒ SPI_WaitFifoStateUntilTimeout

[Calls]

- >> HAL_SPI_TransmitReceive
- >> HAL_GPIO_WritePin

[Called By]

- >> Read_Flash
- >> Init_Flash

W25Q64_SectorErase (Thumb, 344 bytes, Stack size 56 bytes, W25Q64.o(.text.W25Q64_SectorErase))

[Stack]

- Max Depth = 128
- Call Chain = W25Q64_SectorErase ⇒ HAL_SPI_TransmitReceive ⇒ SPI_WaitFifoStateUntilTimeout

[Calls]

- >> HAL_SPI_TransmitReceive
- >> HAL_GPIO_WritePin

[Called By]

- >> Update_Flash
- >> Init_Flash

main (Thumb, 896 bytes, Stack size 136 bytes, main.o(.text.main))

[Stack]

- Max Depth = 508 + Unknown Stack Size
- Call Chain = main ⇒ MX_HRTIM1_Init ⇒ HAL_HRTIM_WaveformTimerConfig

[Calls]

- >> HAL_GPIO_TogglePin
- >> HAL_IWDG_Refresh
- >> HAL_HRTIM_WaveformCountStart
- >> HAL_ADC_Start_DMA
- >> HAL_ADCEx_Calibration_Start
- >> HAL_TIM_Base_Start_IT
- >> HAL_TIM_PWM_Start
- >> MX_SPI3_Init
- >> MX_TIM4_Init
- >> MX_TIM3_Init
- >> MX_TIM8_Init
- >> MX_USART1_UART_Init
- >> MX_TIM2_Init
- >> HAL_RCC_EnableCSS
- >> HAL_RCC_ClockConfig
- >> HAL_RCC_OscConfig
- >> HAL_PWREx_ControlVoltageScaling
- >> HAL_Init
- >> MX_IWDG_Init
- >> MX_I2C3_Init
- >> MX_HRTIM1_Init
- >> MX_GPIO_Init
- >> Auto_FAN
- >> Read_Flash
- >> Update_Flash
- >> Init_Flash
- >> FAN_PWM_set
- >> BUZZER_Middle
- >> BUZZER_Short
- >> HAL_ADC_Start
- >> ADC_calculate
- >> OLED_Display
- >> HAL_Delay
- >> Encoder
- >> USART1_Printf
- >> MX_DMA_Init
- >> MX_ADC5_Init
- >> MX_ADC2_Init
- >> MX_ADC1_Init
- >> PID_Init
- >> HAL_GPIO_WritePin
- >> OLED_ShowChinese
- >> OLED_Clear
- >> OLED_Update
- >> OLED_Init
- >> Key_Init
- >> __aeabi_f2d
- >> __aeabi_dcmplt

[Called By]

- >> __rt_entry_main

_btod_d2e (Thumb, 62 bytes, Stack size 0 bytes, btod.o(CL$$btod_d2e))

[Calls]

- >> _d2e_norm_op1

[Called By]

- >> _fp_digits

_d2e_denorm_low (Thumb, 70 bytes, Stack size 0 bytes, btod.o(CL$$btod_d2e_denorm_low))

[Called By]

- >> _d2e_norm_op1

_d2e_norm_op1 (Thumb, 96 bytes, Stack size 0 bytes, btod.o(CL$$btod_d2e_norm_op1))

[Calls]

- >> _d2e_denorm_low

[Called By]

- >> _btod_d2e

__btod_div_common (Thumb, 696 bytes, Stack size 24 bytes, btod.o(CL$$btod_div_common))

[Stack]

- Max Depth = 24
- Call Chain = __btod_div_common

[Called By]

- >> _btod_ediv

_e2e (Thumb, 220 bytes, Stack size 24 bytes, btod.o(CL$$btod_e2e))

[Stack]

- Max Depth = 24
- Call Chain = _e2e

[Called By]

- >> _btod_emul
- >> _btod_ediv

_btod_ediv (Thumb, 42 bytes, Stack size 28 bytes, btod.o(CL$$btod_ediv))

[Stack]

- Max Depth = 52
- Call Chain = _btod_ediv ⇒ _e2e

[Calls]

- >> _e2e
- >> __btod_div_common

[Called By]

- >> _btod_etento
- >> _fp_digits

_btod_emul (Thumb, 42 bytes, Stack size 28 bytes, btod.o(CL$$btod_emul))

[Stack]

- Max Depth = 52
- Call Chain = _btod_emul ⇒ _e2e

[Calls]

- >> __btod_mult_common
- >> _e2e

[Called By]

- >> _btod_etento
- >> _fp_digits

__btod_mult_common (Thumb, 580 bytes, Stack size 16 bytes, btod.o(CL$$btod_mult_common))

[Stack]

- Max Depth = 16
- Call Chain = __btod_mult_common

[Called By]

- >> _btod_emul

BuckBoostVILoopCtlPID (Thumb, 646 bytes, Stack size 16 bytes, PID.o(ccmram))

[Stack]

- Max Depth = 16
- Call Chain = BuckBoostVILoopCtlPID

[Called By]

- >> HRTIM1_TIMD_IRQHandler

ADCSample (Thumb, 170 bytes, Stack size 16 bytes, function.o(ccmram))

[Stack]

- Max Depth = 16
- Call Chain = ADCSample

[Called By]

- >> HAL_TIM_PeriodElapsedCallback

StateM (Thumb, 352 bytes, Stack size 24 bytes, function.o(ccmram))

[Stack]

- Max Depth = 40
- Call Chain = StateM ⇒ StateMRise

[Calls]

- >> StateMRise
- >> HAL_HRTIM_WaveformOutputStop
- >> HAL_GPIO_WritePin

[Called By]

- >> HAL_TIM_PeriodElapsedCallback

BBMode (Thumb, 432 bytes, Stack size 8 bytes, function.o(ccmram))

[Stack]

- Max Depth = 8
- Call Chain = BBMode

[Called By]

- >> HAL_TIM_PeriodElapsedCallback

__ARM_fpclassify (Thumb, 48 bytes, Stack size 8 bytes, fpclassify.o(i.__ARM_fpclassify))

[Stack]

- Max Depth = 8
- Call Chain = __ARM_fpclassify

[Called By]

- >> _printf_fp_hex_real
- >> _printf_fp_dec_real

__hardfp_log (Thumb, 872 bytes, Stack size 88 bytes, log.o(i.__hardfp_log))

[Stack]

- Max Depth = 144
- Call Chain = __hardfp_log ⇒ __kernel_poly ⇒ __aeabi_dmul

[Calls]

- >> __aeabi_cdcmpeq
- >> __aeabi_dneg
- >> __set_errno
- >> __aeabi_dmul
- >> __aeabi_i2d
- >> __aeabi_ddiv
- >> __aeabi_dsub
- >> __aeabi_drsub
- >> __aeabi_dadd
- >> __kernel_poly
- >> __mathlib_dbl_invalid
- >> __mathlib_dbl_infnan
- >> __mathlib_dbl_divzero

[Called By]

- >> Auto_FAN
- >> OTP
- >> ADC_calculate

__kernel_poly (Thumb, 248 bytes, Stack size 24 bytes, poly.o(i.__kernel_poly))

[Stack]

- Max Depth = 56
- Call Chain = __kernel_poly ⇒ __aeabi_dmul

[Calls]

- >> __aeabi_dmul
- >> __aeabi_dadd

[Called By]

- >> __hardfp_log

__mathlib_dbl_divzero (Thumb, 28 bytes, Stack size 8 bytes, dunder.o(i.__mathlib_dbl_divzero))

[Stack]

- Max Depth = 40
- Call Chain = __mathlib_dbl_divzero ⇒ __aeabi_ddiv

[Calls]

- >> __aeabi_ddiv

[Called By]

- >> __hardfp_log

__mathlib_dbl_infnan (Thumb, 20 bytes, Stack size 8 bytes, dunder.o(i.__mathlib_dbl_infnan))

[Stack]

- Max Depth = 24
- Call Chain = __mathlib_dbl_infnan ⇒ __aeabi_dadd

[Calls]

- >> __aeabi_dadd

[Called By]

- >> __hardfp_log

__mathlib_dbl_invalid (Thumb, 24 bytes, Stack size 8 bytes, dunder.o(i.__mathlib_dbl_invalid))

[Stack]

- Max Depth = 40
- Call Chain = __mathlib_dbl_invalid ⇒ __aeabi_ddiv

[Calls]

- >> __aeabi_ddiv

[Called By]

- >> __hardfp_log

_is_digit (Thumb, 14 bytes, Stack size 0 bytes, __printf_wp.o(i._is_digit))

[Called By]

- >> __printf

_get_lc_numeric (Thumb, 44 bytes, Stack size 8 bytes, lc_numeric_c.o(locale$$code))

[Stack]

- Max Depth = 16
- Call Chain = _get_lc_numeric ⇒ strcmp

[Calls]

- >> strcmp

[Called By]

- >> __rt_lib_init_lc_numeric_2

_get_lc_ctype (Thumb, 44 bytes, Stack size 8 bytes, lc_ctype_c.o(locale$$code))

[Stack]

- Max Depth = 16
- Call Chain = _get_lc_ctype ⇒ strcmp

[Calls]

- >> strcmp

[Called By]

- >> __rt_lib_init_lc_ctype_2

[Address Reference Count : 1]

- rt_ctype_table.o(.text)

__aeabi_dneg (Thumb, 0 bytes, Stack size 0 bytes, basic.o(x$fpl$basic))

[Called By]

- >> __hardfp_log

_dneg (Thumb, 6 bytes, Stack size 0 bytes, basic.o(x$fpl$basic), UNUSED)

__aeabi_fneg (Thumb, 0 bytes, Stack size 0 bytes, basic.o(x$fpl$basic), UNUSED)

_fneg (Thumb, 6 bytes, Stack size 0 bytes, basic.o(x$fpl$basic), UNUSED)

_dabs (Thumb, 6 bytes, Stack size 0 bytes, basic.o(x$fpl$basic), UNUSED)

_fabs (Thumb, 6 bytes, Stack size 0 bytes, basic.o(x$fpl$basic), UNUSED)

__aeabi_d2f (Thumb, 0 bytes, Stack size 32 bytes, d2f.o(x$fpl$d2f))

[Stack]

- Max Depth = 32
- Call Chain = __aeabi_d2f

[Called By]

- >> Auto_FAN
- >> OTP
- >> ADC_calculate
- >> Encoder

_d2f (Thumb, 98 bytes, Stack size 32 bytes, d2f.o(x$fpl$d2f), UNUSED)

[Calls]

- >> __fpl_dnaninf
- >> __fpl_fretinf

__aeabi_dadd (Thumb, 0 bytes, Stack size 16 bytes, daddsub_clz.o(x$fpl$dadd))

[Stack]

- Max Depth = 16
- Call Chain = __aeabi_dadd

[Called By]

- >> Auto_FAN
- >> OTP
- >> ADC_calculate
- >> Encoder
- >> __hardfp_log
- >> __kernel_poly
- >> __mathlib_dbl_infnan

_dadd (Thumb, 332 bytes, Stack size 16 bytes, daddsub_clz.o(x$fpl$dadd), UNUSED)

[Calls]

- >> __fpl_dnaninf
- >> _dsub1
- >> __fpl_dretinf

__fpl_dcmp_Inf (Thumb, 24 bytes, Stack size 0 bytes, dcmpi.o(x$fpl$dcmpinf), UNUSED)

[Called By]

- >> _dcmple
- >> _dcmpge
- >> _dcmpeq

__aeabi_ddiv (Thumb, 0 bytes, Stack size 32 bytes, ddiv.o(x$fpl$ddiv))

[Stack]

- Max Depth = 32
- Call Chain = __aeabi_ddiv

[Called By]

- >> Auto_FAN
- >> OTP
- >> ADC_calculate
- >> __hardfp_log
- >> __mathlib_dbl_invalid
- >> __mathlib_dbl_divzero

_ddiv (Thumb, 556 bytes, Stack size 32 bytes, ddiv.o(x$fpl$ddiv), UNUSED)

[Calls]

- >> __fpl_dnaninf
- >> __fpl_dretinf

__aeabi_cdcmpeq (Thumb, 0 bytes, Stack size 32 bytes, deqf.o(x$fpl$deqf))

[Stack]

- Max Depth = 32
- Call Chain = __aeabi_cdcmpeq

[Called By]

- >> __hardfp_log

_dcmpeq (Thumb, 120 bytes, Stack size 32 bytes, deqf.o(x$fpl$deqf), UNUSED)

[Calls]

- >> __fpl_dnaninf
- >> __fpl_dcmp_Inf

[Called By]

- >> _dneq
- >> _deq

__aeabi_i2d (Thumb, 0 bytes, Stack size 0 bytes, dflt_clz.o(x$fpl$dflt))

[Called By]

- >> __hardfp_log

_dflt (Thumb, 46 bytes, Stack size 0 bytes, dflt_clz.o(x$fpl$dflt), UNUSED)

__aeabi_cdcmpge (Thumb, 0 bytes, Stack size 32 bytes, dgeqf.o(x$fpl$dgeqf), UNUSED)

_dcmpge (Thumb, 120 bytes, Stack size 32 bytes, dgeqf.o(x$fpl$dgeqf), UNUSED)

[Calls]

- >> __fpl_dnaninf
- >> __fpl_dcmp_Inf

[Called By]

- >> _dgeq
- >> _dgr

__aeabi_cdcmple (Thumb, 0 bytes, Stack size 32 bytes, dleqf.o(x$fpl$dleqf), UNUSED)

_dcmple (Thumb, 120 bytes, Stack size 32 bytes, dleqf.o(x$fpl$dleqf), UNUSED)

[Calls]

- >> __fpl_dnaninf
- >> __fpl_dcmp_Inf

[Called By]

- >> _dls
- >> _dleq

__fpl_dcmple_InfNaN (Thumb, 0 bytes, Stack size unknown bytes, dleqf.o(x$fpl$dleqf), UNUSED)

__aeabi_dmul (Thumb, 0 bytes, Stack size 32 bytes, dmul.o(x$fpl$dmul))

[Stack]

- Max Depth = 32
- Call Chain = __aeabi_dmul

[Called By]

- >> __hardfp_log
- >> __kernel_poly

_dmul (Thumb, 332 bytes, Stack size 32 bytes, dmul.o(x$fpl$dmul), UNUSED)

[Calls]

- >> __fpl_dnaninf
- >> __fpl_dretinf

__fpl_dnaninf (Thumb, 156 bytes, Stack size 16 bytes, dnaninf.o(x$fpl$dnaninf), UNUSED)

[Called By]

- >> _dcmple
- >> _dcmpge
- >> _dcmpeq
- >> _dmul
- >> _ddiv
- >> _dsub
- >> _dadd
- >> _d2f

__fpl_dretinf (Thumb, 12 bytes, Stack size 0 bytes, dretinf.o(x$fpl$dretinf), UNUSED)

[Called By]

- >> _f2d
- >> _dmul
- >> _ddiv
- >> _dadd

__aeabi_drsub (Thumb, 0 bytes, Stack size 8 bytes, daddsub_clz.o(x$fpl$drsb))

[Stack]

- Max Depth = 8
- Call Chain = __aeabi_drsub

[Called By]

- >> __hardfp_log

_drsb (Thumb, 22 bytes, Stack size 8 bytes, daddsub_clz.o(x$fpl$drsb), UNUSED)

[Calls]

- >> _dsub1
- >> _dadd1

__aeabi_dsub (Thumb, 0 bytes, Stack size 32 bytes, daddsub_clz.o(x$fpl$dsub))

[Stack]

- Max Depth = 32
- Call Chain = __aeabi_dsub

[Called By]

- >> __hardfp_log

_dsub (Thumb, 472 bytes, Stack size 32 bytes, daddsub_clz.o(x$fpl$dsub), UNUSED)

[Calls]

- >> __fpl_dnaninf
- >> _dadd1

__aeabi_f2d (Thumb, 0 bytes, Stack size 16 bytes, f2d.o(x$fpl$f2d))

[Stack]

- Max Depth = 16
- Call Chain = __aeabi_f2d

[Called By]

- >> main
- >> Auto_FAN
- >> OTP
- >> ADC_calculate
- >> OLED_Display
- >> Encoder

_f2d (Thumb, 86 bytes, Stack size 16 bytes, f2d.o(x$fpl$f2d), UNUSED)

[Calls]

- >> __fpl_fnaninf
- >> __fpl_dretinf

__aeabi_dcmpeq (Thumb, 0 bytes, Stack size 8 bytes, dcmp.o(x$fpl$fcmp), UNUSED)

_deq (Thumb, 14 bytes, Stack size 8 bytes, dcmp.o(x$fpl$fcmp), UNUSED)

[Calls]

- >> _dcmpeq

_dneq (Thumb, 14 bytes, Stack size 8 bytes, dcmp.o(x$fpl$fcmp), UNUSED)

[Calls]

- >> _dcmpeq

__aeabi_dcmpgt (Thumb, 0 bytes, Stack size 8 bytes, dcmp.o(x$fpl$fcmp))

[Stack]

- Max Depth = 8
- Call Chain = __aeabi_dcmpgt

[Called By]

- >> Encoder

_dgr (Thumb, 14 bytes, Stack size 8 bytes, dcmp.o(x$fpl$fcmp), UNUSED)

[Calls]

- >> _dcmpge

__aeabi_dcmpge (Thumb, 0 bytes, Stack size 8 bytes, dcmp.o(x$fpl$fcmp))

[Stack]

- Max Depth = 8
- Call Chain = __aeabi_dcmpge

[Called By]

- >> Encoder

_dgeq (Thumb, 14 bytes, Stack size 8 bytes, dcmp.o(x$fpl$fcmp), UNUSED)

[Calls]

- >> _dcmpge

__aeabi_dcmple (Thumb, 0 bytes, Stack size 8 bytes, dcmp.o(x$fpl$fcmp))

[Stack]

- Max Depth = 8
- Call Chain = __aeabi_dcmple

[Called By]

- >> Encoder

_dleq (Thumb, 14 bytes, Stack size 8 bytes, dcmp.o(x$fpl$fcmp), UNUSED)

[Calls]

- >> _dcmple

__aeabi_dcmplt (Thumb, 0 bytes, Stack size 8 bytes, dcmp.o(x$fpl$fcmp))

[Stack]

- Max Depth = 8
- Call Chain = __aeabi_dcmplt

[Called By]

- >> main
- >> Encoder

_dls (Thumb, 14 bytes, Stack size 8 bytes, dcmp.o(x$fpl$fcmp), UNUSED)

[Calls]

- >> _dcmple

__fpl_fnaninf (Thumb, 140 bytes, Stack size 8 bytes, fnaninf.o(x$fpl$fnaninf), UNUSED)

[Called By]

- >> _f2d

_fp_init (Thumb, 26 bytes, Stack size 0 bytes, fpinit.o(x$fpl$fpinit))

[Called By]

- >> __rt_lib_init_fp_1

__fplib_config_fpu_vfp (Thumb, 0 bytes, Stack size unknown bytes, fpinit.o(x$fpl$fpinit), UNUSED)

__fplib_config_pureend_doubles (Thumb, 0 bytes, Stack size unknown bytes, fpinit.o(x$fpl$fpinit), UNUSED)

__fpl_fretinf (Thumb, 10 bytes, Stack size 0 bytes, fretinf.o(x$fpl$fretinf), UNUSED)

[Called By]

- >> _d2f

_printf_fp_dec (Thumb, 4 bytes, Stack size 0 bytes, printf1.o(x$fpl$printf1))

[Stack]

- Max Depth = 324
- Call Chain = _printf_fp_dec ⇒ _printf_fp_dec_real ⇒ _fp_digits ⇒ _btod_etento ⇒ _btod_emul ⇒ _e2e

[Calls]

- >> _printf_fp_dec_real

[Called By]

- >> _printf_g
- >> _printf_e
- >> _printf_f

_printf_fp_hex (Thumb, 4 bytes, Stack size 0 bytes, printf2.o(x$fpl$printf2))

[Stack]

- Max Depth = 112
- Call Chain = _printf_fp_hex ⇒ _printf_fp_hex_real ⇒ _printf_fp_infnan ⇒ _printf_post_padding

[Calls]

- >> _printf_fp_hex_real

[Called By]

- >> _printf_a

### Local Symbols

HRTIM_OutputConfig (Thumb, 246 bytes, Stack size 24 bytes, stm32g4xx_hal_hrtim.o(.text.HRTIM_OutputConfig))

[Stack]

- Max Depth = 24
- Call Chain = HRTIM_OutputConfig

[Called By]

- >> HAL_HRTIM_WaveformOutputConfig

I2C_IsErrorOccurred (Thumb, 348 bytes, Stack size 16 bytes, stm32g4xx_hal_i2c.o(.text.I2C_IsErrorOccurred))

[Stack]

- Max Depth = 16
- Call Chain = I2C_IsErrorOccurred

[Calls]

- >> HAL_GetTick

[Called By]

- >> HAL_I2C_Master_Transmit
- >> I2C_WaitOnSTOPFlagUntilTimeout
- >> I2C_WaitOnFlagUntilTimeout
- >> I2C_WaitOnTXISFlagUntilTimeout

I2C_WaitOnTXISFlagUntilTimeout (Thumb, 152 bytes, Stack size 16 bytes, stm32g4xx_hal_i2c.o(.text.I2C_WaitOnTXISFlagUntilTimeout))

[Stack]

- Max Depth = 32
- Call Chain = I2C_WaitOnTXISFlagUntilTimeout ⇒ I2C_IsErrorOccurred

[Calls]

- >> HAL_GetTick
- >> I2C_IsErrorOccurred

[Called By]

- >> HAL_I2C_Master_Transmit

I2C_WaitOnFlagUntilTimeout (Thumb, 228 bytes, Stack size 24 bytes, stm32g4xx_hal_i2c.o(.text.I2C_WaitOnFlagUntilTimeout))

[Stack]

- Max Depth = 40
- Call Chain = I2C_WaitOnFlagUntilTimeout ⇒ I2C_IsErrorOccurred

[Calls]

- >> HAL_GetTick
- >> I2C_IsErrorOccurred

[Called By]

- >> HAL_I2C_Master_Transmit

I2C_WaitOnSTOPFlagUntilTimeout (Thumb, 124 bytes, Stack size 16 bytes, stm32g4xx_hal_i2c.o(.text.I2C_WaitOnSTOPFlagUntilTimeout))

[Stack]

- Max Depth = 32
- Call Chain = I2C_WaitOnSTOPFlagUntilTimeout ⇒ I2C_IsErrorOccurred

[Calls]

- >> HAL_GetTick
- >> I2C_IsErrorOccurred

[Called By]

- >> HAL_I2C_Master_Transmit

SPI_WaitFifoStateUntilTimeout (Thumb, 382 bytes, Stack size 40 bytes, stm32g4xx_hal_spi.o(.text.SPI_WaitFifoStateUntilTimeout))

[Stack]

- Max Depth = 40
- Call Chain = SPI_WaitFifoStateUntilTimeout

[Calls]

- >> HAL_GetTick

[Called By]

- >> HAL_SPI_TransmitReceive

SPI_WaitFlagStateUntilTimeout (Thumb, 206 bytes, Stack size 24 bytes, stm32g4xx_hal_spi.o(.text.SPI_WaitFlagStateUntilTimeout))

[Stack]

- Max Depth = 24
- Call Chain = SPI_WaitFlagStateUntilTimeout

[Calls]

- >> HAL_GetTick

[Called By]

- >> HAL_SPI_TransmitReceive

UART_DMAError (Thumb, 474 bytes, Stack size 0 bytes, stm32g4xx_hal_uart.o(.text.UART_DMAError))

[Calls]

- >> HAL_UART_ErrorCallback

[Address Reference Count : 1]

- stm32g4xx_hal_uart.o(.text.HAL_UART_Transmit_DMA)

UART_DMATransmitCplt (Thumb, 176 bytes, Stack size 0 bytes, stm32g4xx_hal_uart.o(.text.UART_DMATransmitCplt))

[Calls]

- >> HAL_UART_TxCpltCallback

[Address Reference Count : 1]

- stm32g4xx_hal_uart.o(.text.HAL_UART_Transmit_DMA)

UART_DMATxHalfCplt (Thumb, 6 bytes, Stack size 0 bytes, stm32g4xx_hal_uart.o(.text.UART_DMATxHalfCplt))

[Calls]

- >> HAL_UART_TxHalfCpltCallback

[Address Reference Count : 1]

- stm32g4xx_hal_uart.o(.text.HAL_UART_Transmit_DMA)

UART_DMAAbortOnError (Thumb, 16 bytes, Stack size 0 bytes, stm32g4xx_hal_uart.o(.text.UART_DMAAbortOnError))

[Calls]

- >> HAL_UART_ErrorCallback

[Address Reference Count : 1]

- stm32g4xx_hal_uart.o(.text.HAL_UART_IRQHandler)

_dadd1 (Thumb, 0 bytes, Stack size unknown bytes, daddsub_clz.o(x$fpl$dadd), UNUSED)

[Called By]

- >> _dsub
- >> _drsb

_dsub1 (Thumb, 0 bytes, Stack size unknown bytes, daddsub_clz.o(x$fpl$dsub), UNUSED)

[Called By]

- >> _drsb
- >> _dadd

_printf_input_char (Thumb, 10 bytes, Stack size 0 bytes, _printf_char_common.o(.text))
[Address Reference Count : 1]

- _printf_char_common.o(.text)

_fp_digits (Thumb, 432 bytes, Stack size 96 bytes, _printf_fp_dec.o(.text))

[Stack]

- Max Depth = 220
- Call Chain = _fp_digits ⇒ _btod_etento ⇒ _btod_emul ⇒ _e2e

[Calls]

- >> _btod_emul
- >> _btod_ediv
- >> _btod_d2e
- >> _btod_etento
- >> _ll_udiv10

[Called By]

- >> _printf_fp_dec_real

### Undefined Global Symbols
