zeruns/Synchronous-Rectification-Buck-Boost-Digital-Power-Supply-Based-on-STM32/(threads)

Thread 2 (2024-06-12):

寻求课程合作

specialtantan, 2024-06-12:
hi，我们是蓝桥云课，是一家在线教育平台，偶然关注到您的这个项目，我们很有兴趣，旗下的蓝桥杯大赛中也有电子类赛项，您的项目很适合这部分同学学习，所以想了解下您是否有兴趣基于此项目制作一门课程，上线到我们平台，相信会为您带来不错的收益，若您有兴趣尝试，欢迎联系我们的官方合作微信：shiyanloukecheng～

Closed 2024-10-30.
