zeruns/Synchronous-Rectification-Buck-Boost-Digital-Power-Supply-Based-on-STM32/Core/Src/main.c

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
/* Includes ------------------------------------------------------------------*/
#include "main.h"
#include "adc.h"
#include "dma.h"
#include "hrtim.h"
#include "i2c.h"
#include "iwdg.h"
#include "spi.h"
#include "tim.h"
#include "usart.h"
#include "gpio.h"

/* USER CODE BEGIN Includes */
#include "OLED.h"
#include "function.h"
#include "Key.h"
#include "PID.h"
#include "W25Q64.h"
/* USER CODE END Includes */

/* USER CODE BEGIN PD */
// #define REF_3V3 3.2993 // VREF参考电压
/* USER CODE END PD */


/* USER CODE BEGIN PV */
// 毫秒计时变量
volatile uint16_t ms_cnt_1 = 0; // 计时变量1
volatile uint16_t ms_cnt_2 = 0; // 计时变量2
volatile uint16_t ms_cnt_3 = 0; // 计时变量3
volatile uint16_t ms_cnt_4 = 0; // 计时变量4
/* USER CODE END PV */

void SystemClock_Config(void);
/**
 * @brief  The application entry point.
 * @retval int
 */
int main(void)
{
  /* MCU Configuration--------------------------------------------------------*/

  /* Reset of all peripherals, Initializes the Flash interface and the Systick. */
  HAL_Init();

  /* Configure the system clock */
  SystemClock_Config();

  /* Initialize all configured peripherals */
  MX_GPIO_Init();
  MX_DMA_Init();
  MX_TIM2_Init();
  MX_I2C3_Init();
  MX_ADC1_Init();
  MX_ADC2_Init();
  MX_USART1_UART_Init();
  MX_TIM8_Init();
  MX_ADC5_Init();
  MX_HRTIM1_Init();
  MX_TIM3_Init();
  MX_IWDG_Init();
  MX_TIM4_Init();
  MX_SPI3_Init();
  /* USER CODE BEGIN 2 */
  DF.SMFlag = Init;                         // 初始化状态机
  HAL_TIM_PWM_Start(&htim8, TIM_CHANNEL_3); // 启动定时器8和通道3的PWM输出
  FAN_PWM_set(100);                         // 设置风扇转速为100%
  OLED_Init();                              // OLED初始化
  OLED_Clear();                             // 清除OLED屏显示缓冲区
  OLED_ShowChinese(40, 24, "启动中");       // 在屏幕中间显示 启动中
  OLED_Update();                            // 更新OLED显示内容
  HAL_TIM_Base_Start_IT(&htim2);            // 启动定时器2和定时器中断，1kHz
  HAL_TIM_Base_Start_IT(&htim3);            // 启动定时器3和定时器中断，200Hz
  HAL_TIM_Base_Start_IT(&htim4);            // 启动定时器4和定时器中断，100Hz
  Key_Init();                               // 按键状态机初始化
  PID_Init();                               // PID初始化
  Init_Flash();                             // Flash初始化
  Read_Flash();                             // 读取Flash数据

  HAL_Delay(200);                                        // 延时100ms，等待供电稳定
  HAL_ADCEx_Calibration_Start(&hadc1, ADC_SINGLE_ENDED); // 校准ADC1
  HAL_ADCEx_Calibration_Start(&hadc2, ADC_SINGLE_ENDED); // 校准ADC2
  HAL_ADCEx_Calibration_Start(&hadc5, ADC_SINGLE_ENDED); // 校准ADC5
  HAL_ADC_Start_DMA(&hadc1, (uint32_t *)ADC1_RESULT, 4); // 启动ADC1采样和DMA数据传送,采样输入输出电压电流
  HAL_ADC_Start(&hadc2);                                 // 启动ADC2采样，采样NTC温度
  HAL_ADC_Start(&hadc5);                                 // 启动ADC5采样，采样单片机CPU温度

  //__HAL_HRTIM_SETCOMPARE(&hhrtim1, HRTIM_TIMERINDEX_TIMER_D, HRTIM_COMPAREUNIT_1, 30000 - 18000); // 设置HRTIM定时器D的比较单元1的值（设置PWM占空比）
  //__HAL_HRTIM_SETCOMPARE(&hhrtim1, HRTIM_TIMERINDEX_TIMER_D, HRTIM_COMPAREUNIT_3, 15000);         // 设置HRTIM定时器D的比较单元3的值（设置触发ADC采样的比较值）
  //__HAL_HRTIM_SETCOMPARE(&hhrtim1, HRTIM_TIMERINDEX_TIMER_F, HRTIM_COMPAREUNIT_1, 1800);          // 设置HRTIM定时器F的比较单元1的值（设置PWM占空比）
  // HAL_HRTIM_WaveformOutputStart(&hhrtim1, HRTIM_OUTPUT_TD1 | HRTIM_OUTPUT_TD2);                   // 开启HRTIM的PWM输出
  // HAL_HRTIM_WaveformOutputStart(&hhrtim1, HRTIM_OUTPUT_TF1 | HRTIM_OUTPUT_TF2);                   // 开启HRTIM的PWM输出

  HAL_HRTIM_WaveformCountStart(&hhrtim1, HRTIM_TIMERID_TIMER_D);                     // 开启HRTIM波形计数器
  HAL_HRTIM_WaveformCountStart(&hhrtim1, HRTIM_TIMERID_TIMER_F);                     // 开启HRTIM波形计数器
  __HAL_HRTIM_TIMER_ENABLE_IT(&hhrtim1, HRTIM_TIMERINDEX_TIMER_D, HRTIM_TIM_IT_REP); // 开启HRTIM定时器D的中断

  HAL_GPIO_WritePin(GPIOC, LED_G_Pin | LED_R_Pin, GPIO_PIN_RESET); // 关闭LED_G和LED_R
  HAL_GPIO_WritePin(BUZZER_GPIO_Port, BUZZER_Pin, GPIO_PIN_RESET); // 关闭蜂鸣器

  FAN_PWM_set(0); // 设置风扇转速为0

  /* USER CODE END 2 */

  /* Infinite loop */
  /* USER CODE BEGIN WHILE */
  while (1)
  {
    /* USER CODE END WHILE */

    /* USER CODE BEGIN 3 */
    Encoder(); // 编码器信号处理

    if (ms_cnt_3 >= 10) // 判断是否计时到10ms
    {
      ms_cnt_3 = 0;    // 计时清零
      BUZZER_Short();  // 蜂鸣器短促鸣叫
      ADC_calculate(); // ADC采样结果计算
    }

    if (ms_cnt_4 >= 50) // 判断是否计时到50ms
    {
      ms_cnt_4 = 0;    // 计时清零
      BUZZER_Middle(); // 蜂鸣器中速鸣叫

      if ((DF.SMFlag == Rise) || (DF.SMFlag == Run)) // 判断当前状态
      {
        HAL_GPIO_WritePin(LED_G_GPIO_Port, LED_G_Pin, GPIO_PIN_SET); // LED_G输出状态指示灯亮
      }
      else
      {
        HAL_GPIO_WritePin(LED_G_GPIO_Port, LED_G_Pin, GPIO_PIN_RESET); // LED_G输出状态指示灯灭
      }

      if (IOUT >= 0.1)
      {
        powerEfficiency = (VOUT * IOUT) / (VIN * IIN) * 100.0; // 计算电源转换效率
      }
      else
      {
        powerEfficiency = 0;
      }

      USART1_Printf("%.3f,%.3f,%.3f,%.3f,%.2f,%.2f,%.2f,%d\n", VIN, IIN, VOUT, IOUT, MainBoard_TEMP, CPU_TEMP, powerEfficiency, CVCC_Mode); // 串口发送数据
    }

    if (ms_cnt_2 >= 100) // 判断是否计时到100ms
    {
      ms_cnt_2 = 0;   // 计时清零
      OLED_Display(); // 刷新OLED屏显示内容
      Auto_FAN();     // 风扇转速控制
    }

    if (ms_cnt_1 >= 500) // 判断是否计时到500ms
    {
      ms_cnt_1 = 0;                                   // 计时清零
      HAL_GPIO_TogglePin(LED_R_GPIO_Port, LED_R_Pin); // LED_R电平翻转
      Update_Flash();                                 // 更新Flash存储内容
      
    }

    HAL_IWDG_Refresh(&hiwdg); // 喂狗
  }
  /* USER CODE END 3 */
}

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
/* USER CODE BEGIN 4 */

/**
 * @brief HAL_TIM_PeriodElapsedCallback函数,中断回调函数
 *
 * 当定时器周期结束时，该函数将被调用。
 *
 * @param htim TIM句柄指针
 */
void HAL_TIM_PeriodElapsedCallback(TIM_HandleTypeDef *htim)
{
  if (htim->Instance == TIM2) // 定时器TIM2，中断时间1ms
  {
    ms_cnt_1++;
    ms_cnt_2++;
    ms_cnt_3++;
    ms_cnt_4++;
  }
  if (htim->Instance == TIM3) // 定时器TIM3，中断时间5ms
  {
    ADCSample(); // ADC采样滤波函数
    ShortOff();  // 短路保护
    OTP();       // 过温保护
    OVP();       // 输出过压保护
    OCP();       // 输出过流保护
    StateM();    // 电源状态机函数
    BBMode();    // 运行模式判断
  }
  if (htim->Instance == TIM4) // 定时器TIM4，中断时间10ms
  {
    KEY_Scan(1, KEY1);        // 按键1扫描
    KEY_Scan(2, KEY2);        // 按键2扫描
    KEY_Scan(3, Encoder_KEY); // 编码器按键扫描
    Key_Process();            // 按键按下的处理
  }
}

/* USER CODE END 4 */
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
