zeruns/Synchronous-Rectification-Buck-Boost-Digital-Power-Supply-Based-on-STM32/Core/Hardware/W25Q64.c

#include "W25Q64.h"
#include "W25Q64_Ins.h"
#include "spi.h"
#include "function.h"

/**
 * @brief 开始 W25Q64 SPI 通信。
 * 在开始与 W25Q64 存储器通信之前，需要先调用此函数。
 * 该函数会将 Flash_CS_Pin 引脚设置为低电平，以启动 SPI 通信。
 */
void W25Q64_SPIStart(void)
{
	HAL_GPIO_WritePin(Flash_CS_GPIO_Port, Flash_CS_Pin, GPIO_PIN_RESET);
}

/**
 * @brief 停止W25Q64 SPI通信。
 * 将Flash_CS_Pin设置为高电平，停止W25Q64通信。
 */
void W25Q64_SPIStop(void)
{
	HAL_GPIO_WritePin(Flash_CS_GPIO_Port, Flash_CS_Pin, GPIO_PIN_SET);
}

/**
 * @brief SPI 交换字节。
 * 通过 SPI 接口发送一个字节数据，并接收返回的数据。
 * @param ByteSend 要发送的字节数据
 * @return 接收到的字节数据
 */
uint8_t MySPI_SwapByte(uint8_t ByteSend)
{
	uint8_t rxData = 0;													   // 用于接收数据的变量
	HAL_SPI_TransmitReceive(&hspi3, &ByteSend, &rxData, 1, HAL_MAX_DELAY); // SPI发送数据并接收数据
	return rxData;
}

void W25Q64_ReadID(uint8_t *MID, uint16_t *DID)
{
	W25Q64_SPIStart();
	MySPI_SwapByte(W25Q64_JEDEC_ID);
	*MID = MySPI_SwapByte(W25Q64_DUMMY_BYTE);
	*DID = MySPI_SwapByte(W25Q64_DUMMY_BYTE);
	*DID <<= 8;
	*DID |= MySPI_SwapByte(W25Q64_DUMMY_BYTE);
	W25Q64_SPIStop();
}

void W25Q64_WriteEnable(void)
{
	W25Q64_SPIStart();
	MySPI_SwapByte(W25Q64_WRITE_ENABLE);
	W25Q64_SPIStop();
}

void W25Q64_WaitBusy(void)
{
	uint32_t Timeout;
	W25Q64_SPIStart();
	MySPI_SwapByte(W25Q64_READ_STATUS_REGISTER_1);
	Timeout = 100000;
	while ((MySPI_SwapByte(W25Q64_DUMMY_BYTE) & 0x01) == 0x01)
	{
		Timeout--;
		if (Timeout == 0)
		{
			break;
		}
	}
	W25Q64_SPIStop();
}

void W25Q64_PageProgram(uint32_t Address, uint8_t *DataArray, uint16_t Count)
{
	uint16_t i;

	W25Q64_WaitBusy();

	W25Q64_WriteEnable();

	W25Q64_SPIStart();
	MySPI_SwapByte(W25Q64_PAGE_PROGRAM);
	MySPI_SwapByte(Address >> 16);
	MySPI_SwapByte(Address >> 8);
	MySPI_SwapByte(Address);
	for (i = 0; i < Count; i++)
	{
		MySPI_SwapByte(DataArray[i]);
	}
	W25Q64_SPIStop();
}

void W25Q64_SectorErase(uint32_t Address)
{
	W25Q64_WaitBusy();

	W25Q64_WriteEnable();

	W25Q64_SPIStart();
	MySPI_SwapByte(W25Q64_SECTOR_ERASE_4KB);
	MySPI_SwapByte(Address >> 16);
	MySPI_SwapByte(Address >> 8);
	MySPI_SwapByte(Address);
	W25Q64_SPIStop();
}

void W25Q64_ReadData(uint32_t Address, uint8_t *DataArray, uint32_t Count)
{
	uint32_t i;
	
	W25Q64_WaitBusy();

	W25Q64_SPIStart();
	MySPI_SwapByte(W25Q64_READ_DATA);
	MySPI_SwapByte(Address >> 16);
	MySPI_SwapByte(Address >> 8);
	MySPI_SwapByte(Address);
	for (i = 0; i < Count; i++)
	{
		DataArray[i] = MySPI_SwapByte(W25Q64_DUMMY_BYTE);
	}
	W25Q64_SPIStop();
}
