zeruns/Synchronous-Rectification-Buck-Boost-Digital-Power-Supply-Based-on-STM32/(commit log)

2024-04-20 加入故障状态时蜂鸣器鸣叫功能
2024-04-20 加入了W25Q64的驱动，完善了过温保护功能
2024-04-21 加入自动存储设置值到Flash的功能，可设置过压过流过温保护的阈值
2024-04-21 增加了风扇转速根据温度自动控制的功能
2024-04-21 Revert "增加了风扇转速根据温度自动控制的功能"
    This reverts commit 16d0a6f7e91e913ce61dac74e66c94d606674cab.
    [OLED_Data.c, function.c, function.h, main.c]
2024-06-04 更新了README文件
